githubgilhad/HW-001/HW/KiCad/retro-001/retro-001.png

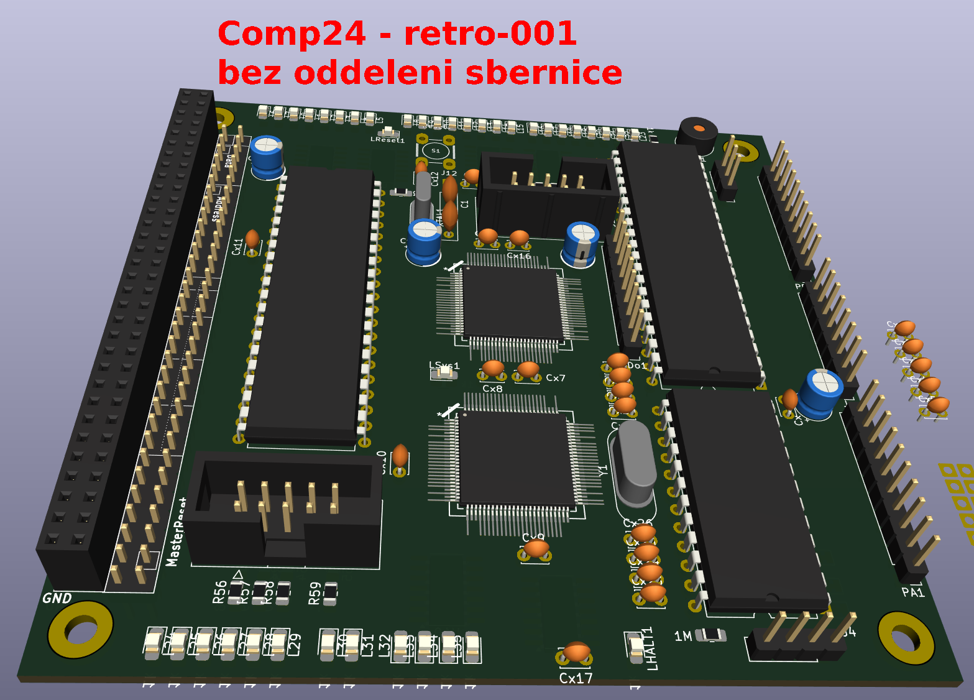
HW/KiCad/retro-001/retro-001.png
