githubgilhad/HW-001/README

HW deska pro CPU+RAM+GLUE+SystemBus - prvni navrh
