githubgilhad/HW-001/HW/KiCad/graphic_card.rst

/home/gilhad/GIT-ghub/Arduino/Video/MegaHomeFORTH/docs/graphic_card.rst
