githubgilhad/HW-001/HW/KiCad/retro-003/retro-003.back.png

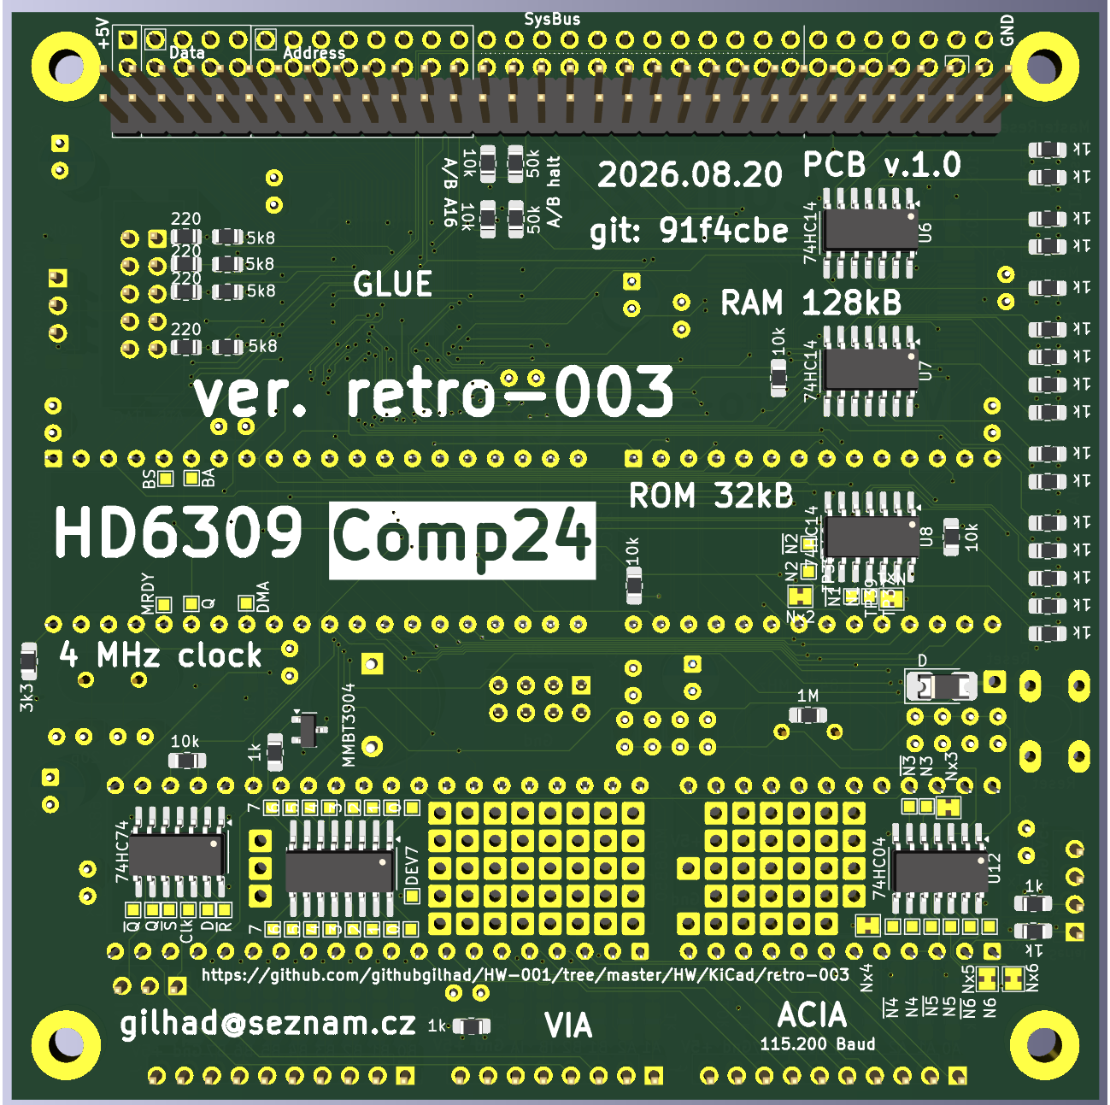
HW/KiCad/retro-003/retro-003.back.png
