githubgilhad/HW-001/HW/KiCad/retro-003/retro-003.front.png

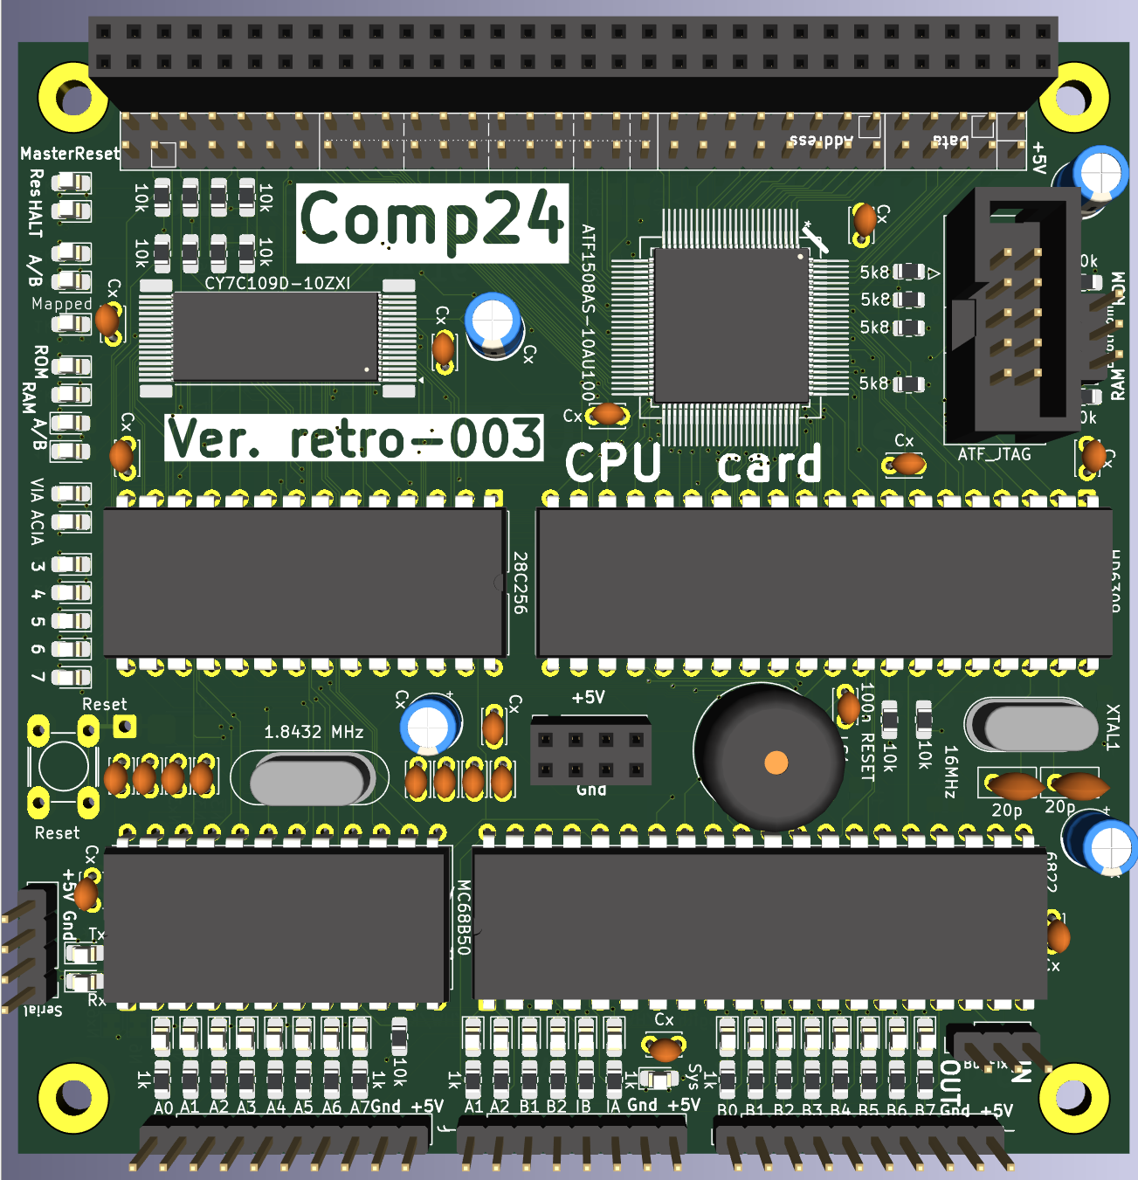
HW/KiCad/retro-003/retro-003.front.png
