githubgilhad/HW-001/PLD/SOviewer/background-retro3-simil-clean.png

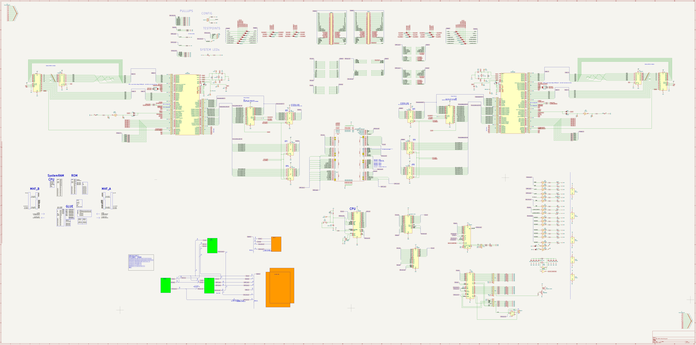
PLD/SOviewer/background-retro3-simil-clean.png
