githubgilhad/HW-001/PLD/SOviewer/background-retro3-simul.png

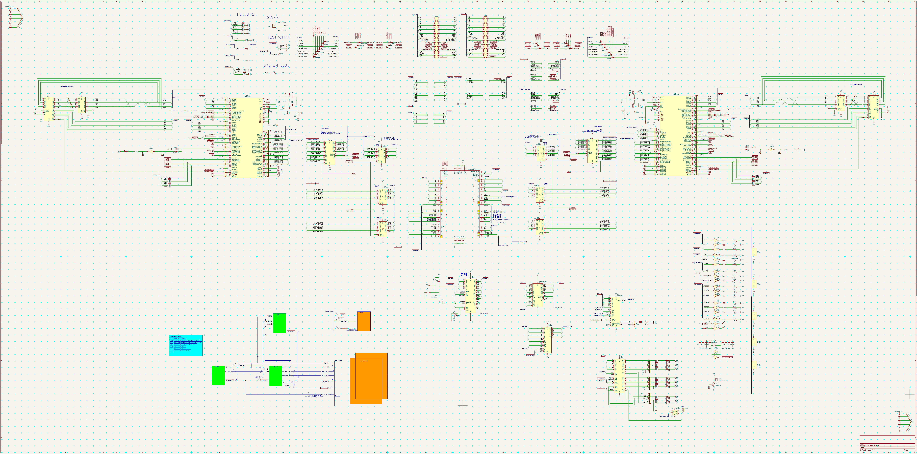
PLD/SOviewer/background-retro3-simul.png
