githubgilhad/HW-001/PLD/SOviewer/background-retro3.small.png

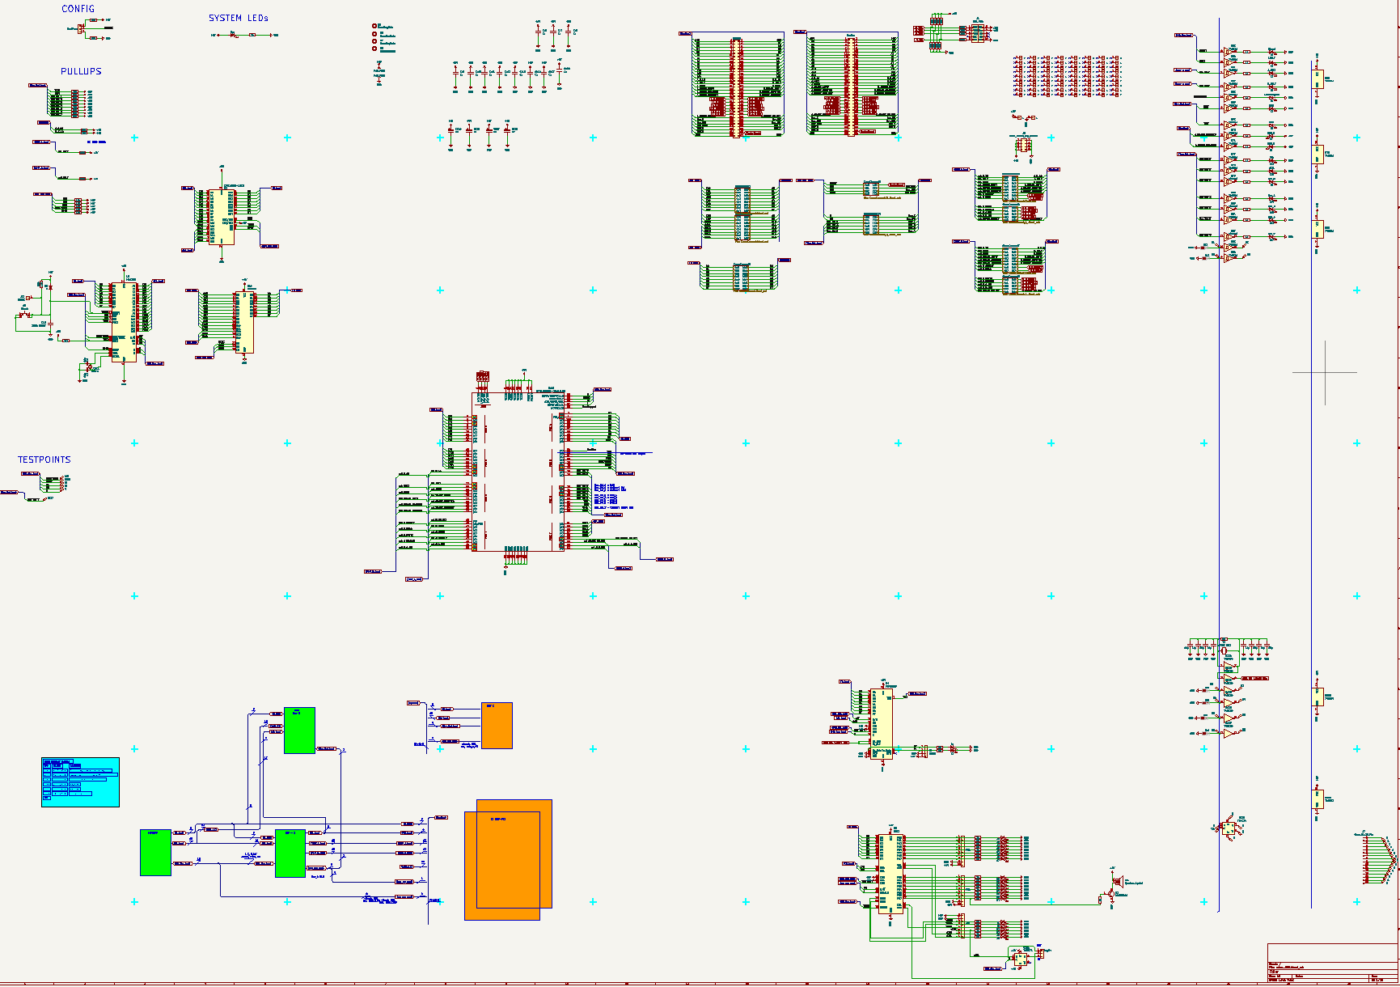
PLD/SOviewer/background-retro3.small.png
