githubgilhad/HW-001/PLD/SOviewer/w-2026-09-04_14:53:48_2492x1393.png

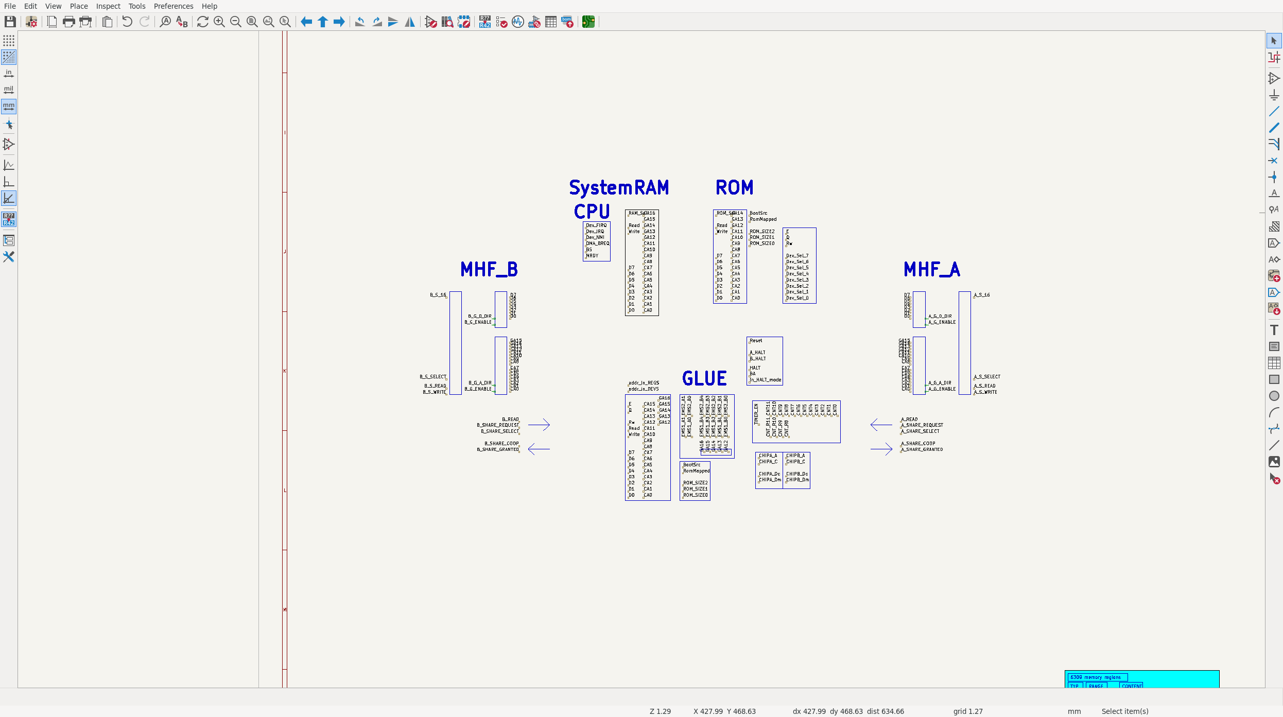
PLD/SOviewer/w-2026-09-04_14:53:48_2492x1393.png
