githubgilhad/HW-001/HW/KiCad/retro-003/STEP Files/EEHZA1E470P.step

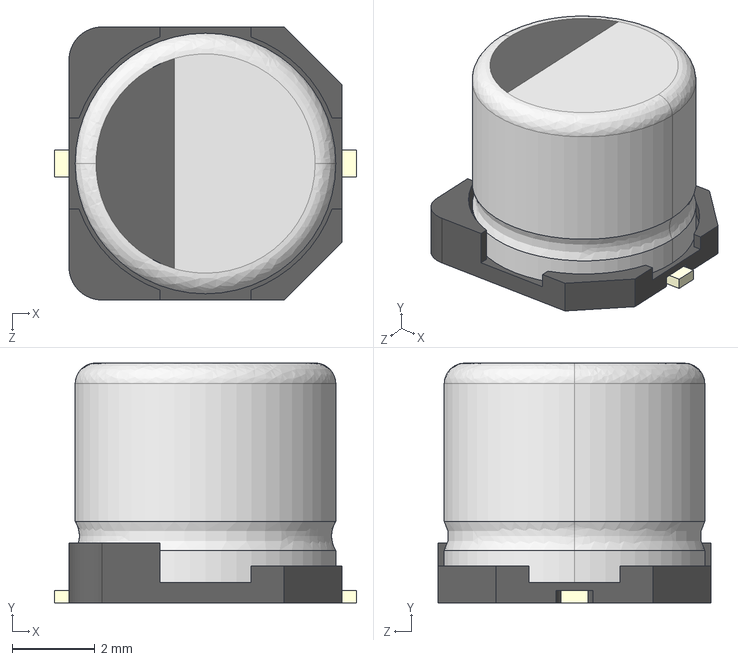
[picture p9: CAD file, 2026-05-15]
HW/KiCad/retro-003/STEP Files/EEHZA1E470P.step
7.30 x 5.80 x 6.60 mm
