githubgilhad/HW-001/HW/KiCad/retro-003/STEP Files/CUI_DEVICES_TS06-667-30-BK-100-G-SMT-TR.step

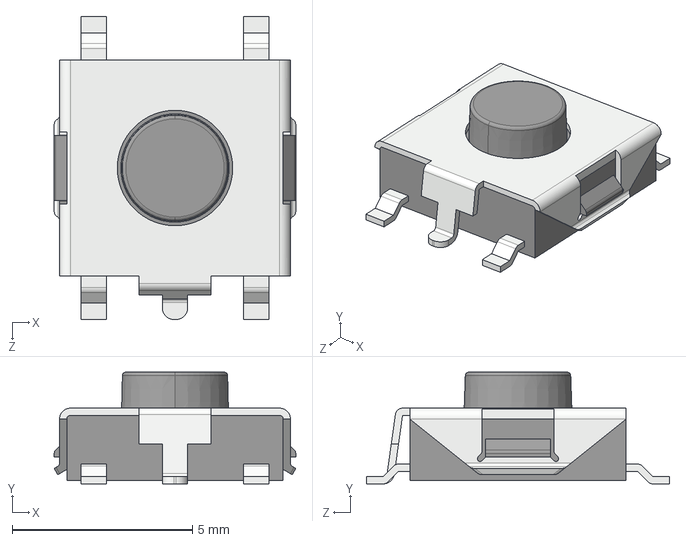
[picture p10: CAD file, 2026-05-15]
HW/KiCad/retro-003/STEP Files/CUI_DEVICES_TS06-667-30-BK-100-G-SMT-TR.step
6.70 x 3.10 x 8.40 mm
