githubgilhad/HW-001/HW/KiCad/retro-003/PCB.pdf

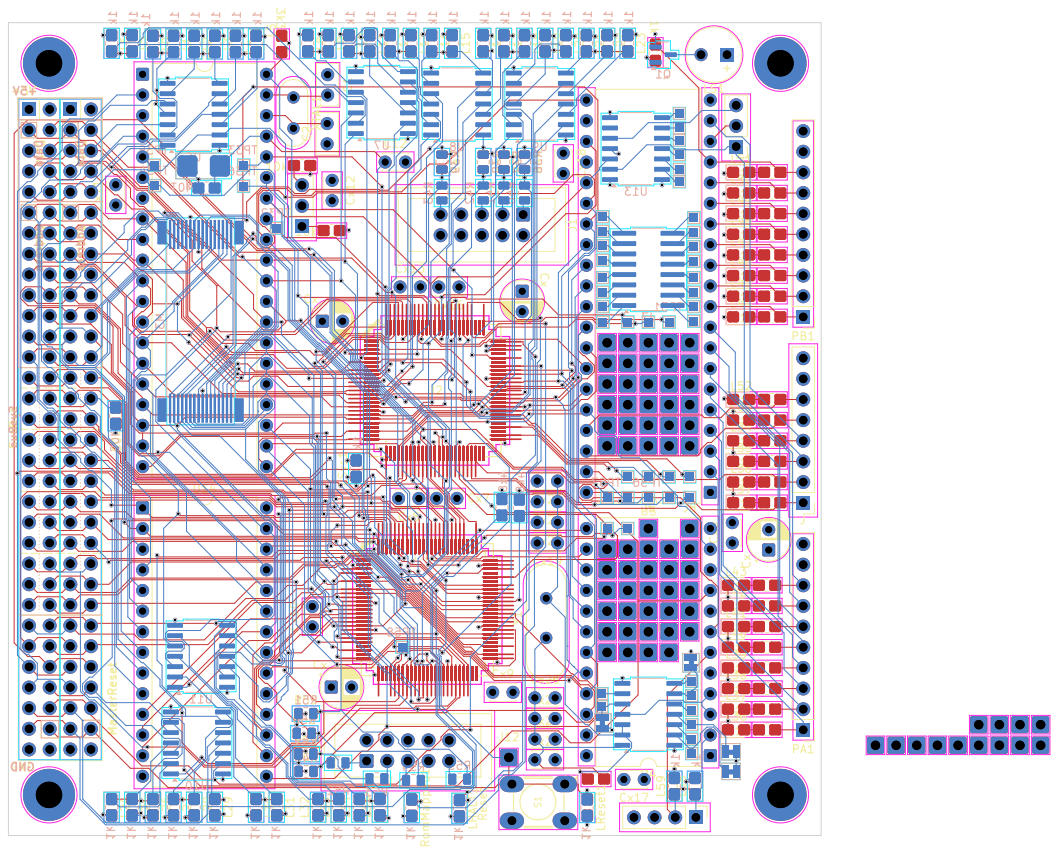
[picture p11: page 1]
