githubgilhad/HW-001/HW/KiCad/retro-003/SCHEMA.pdf

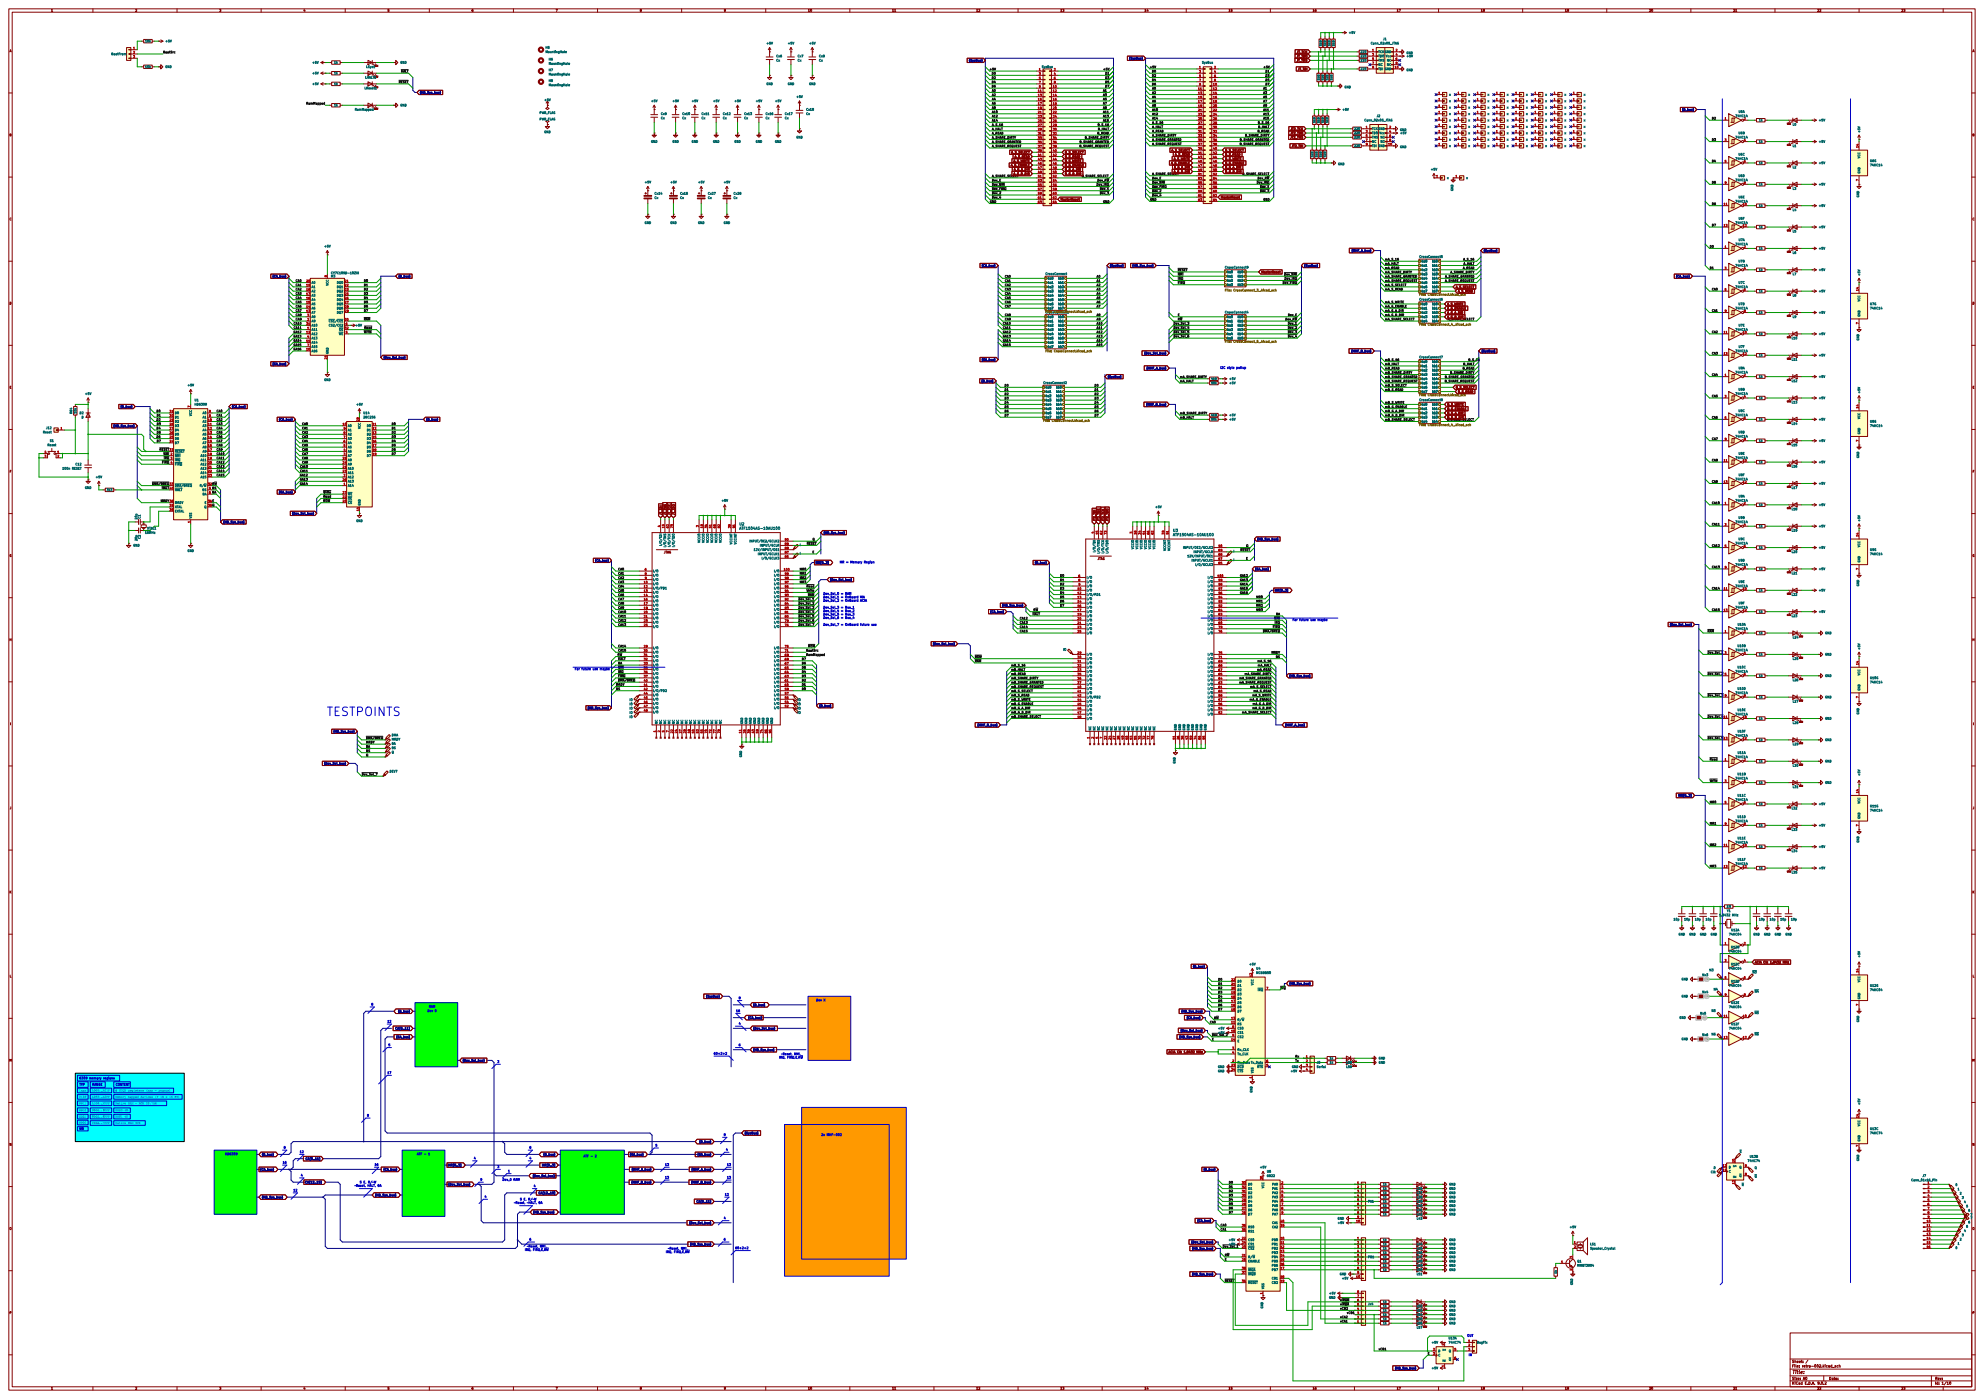
[picture p12: page 1]

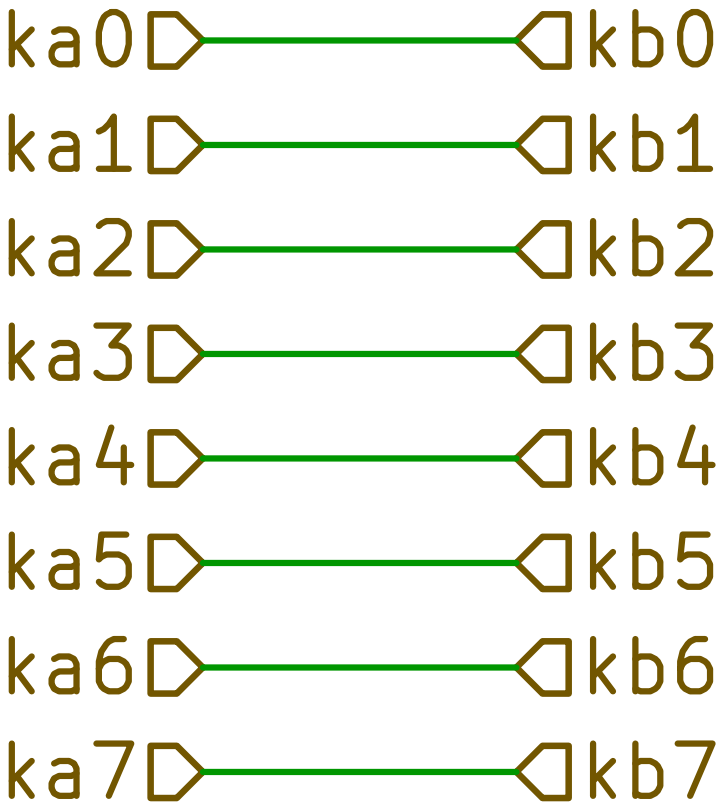
[picture p13: page 2]

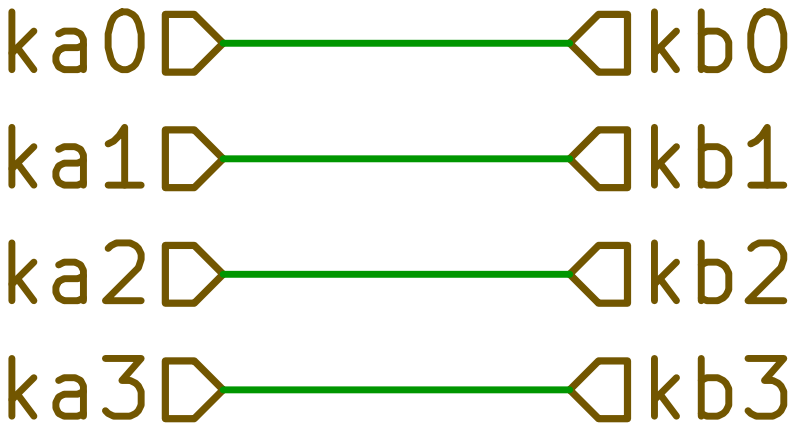
[picture p14: page 5]

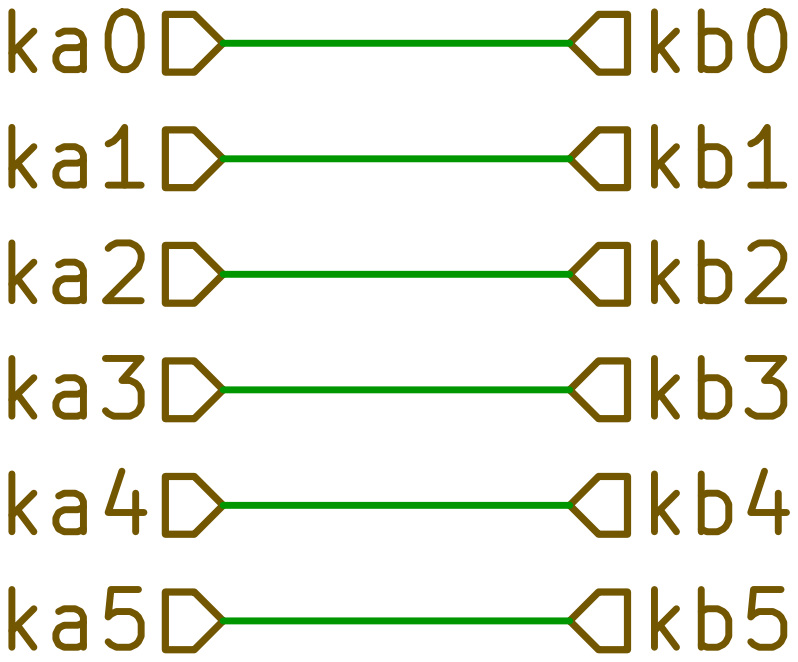
[picture p15: page 6]

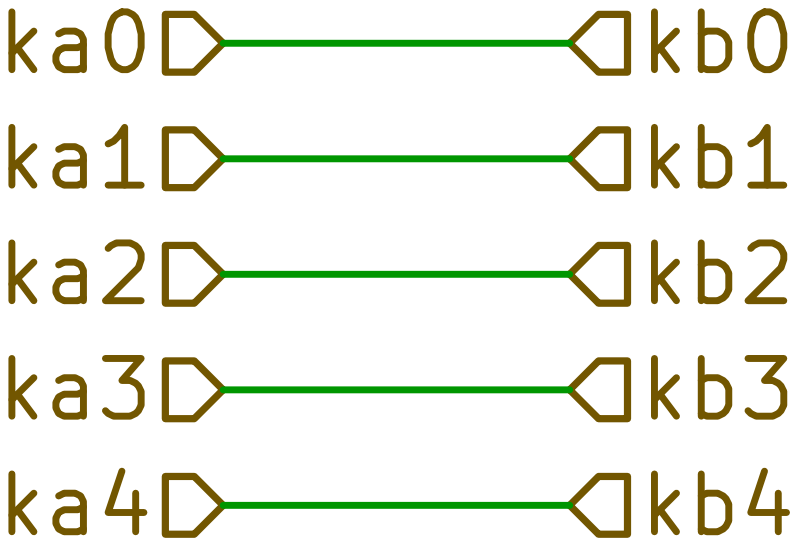
[picture p16: page 8]
