githubgilhad/HW-001/HW/KiCad/retro-001/output.pdf

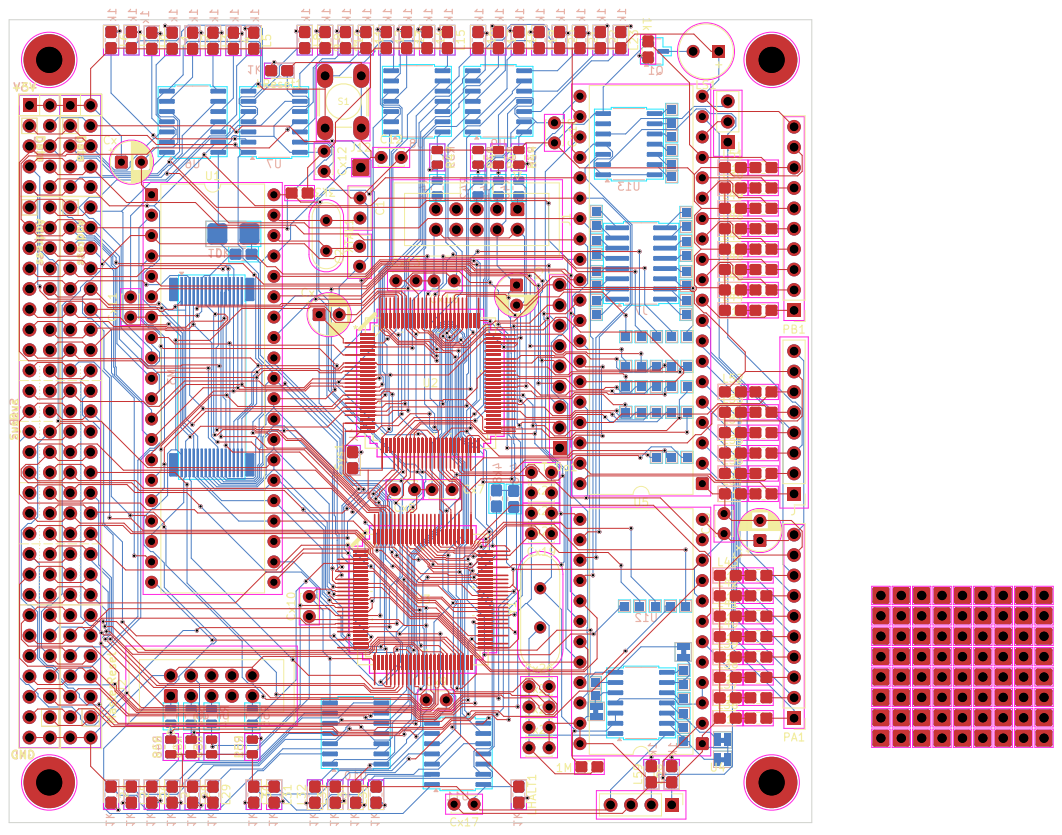
[picture p17: page 1]
