githubgilhad/HW-001/HW/KiCad/retro-001/PCB.pdf

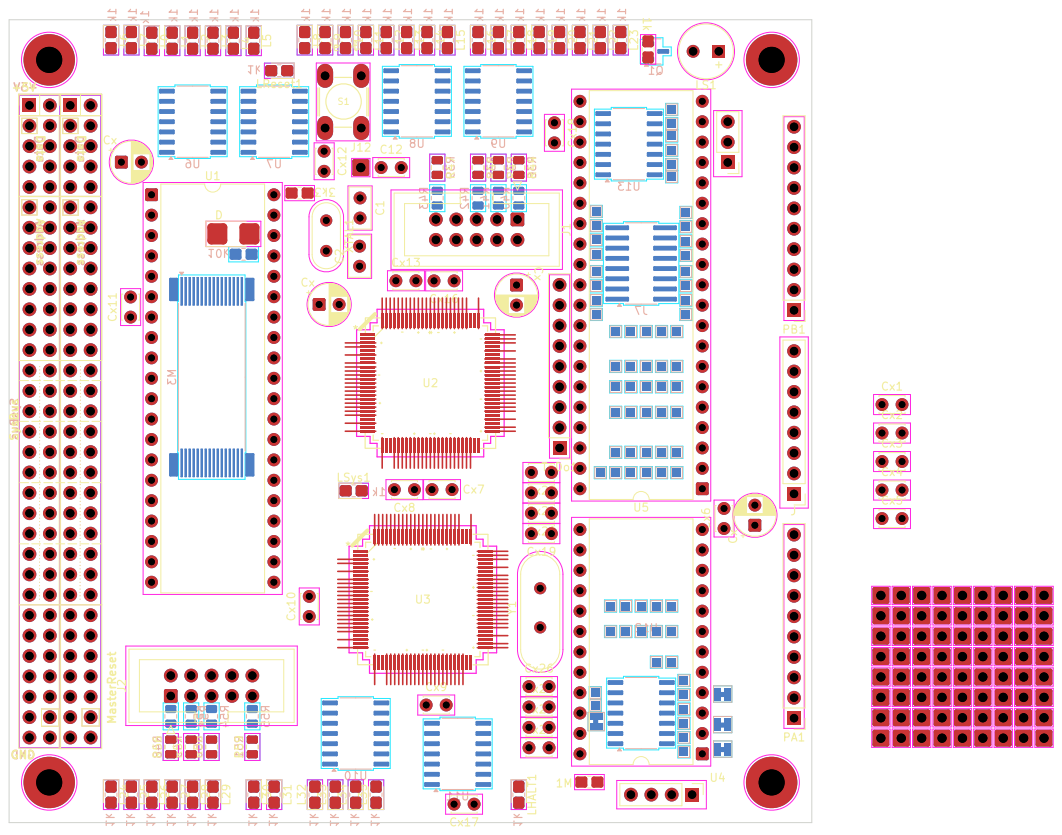
[picture p18: page 1]
