githubgilhad/HW-001/HW/KiCad/retro-001/SCHEMA.pdf

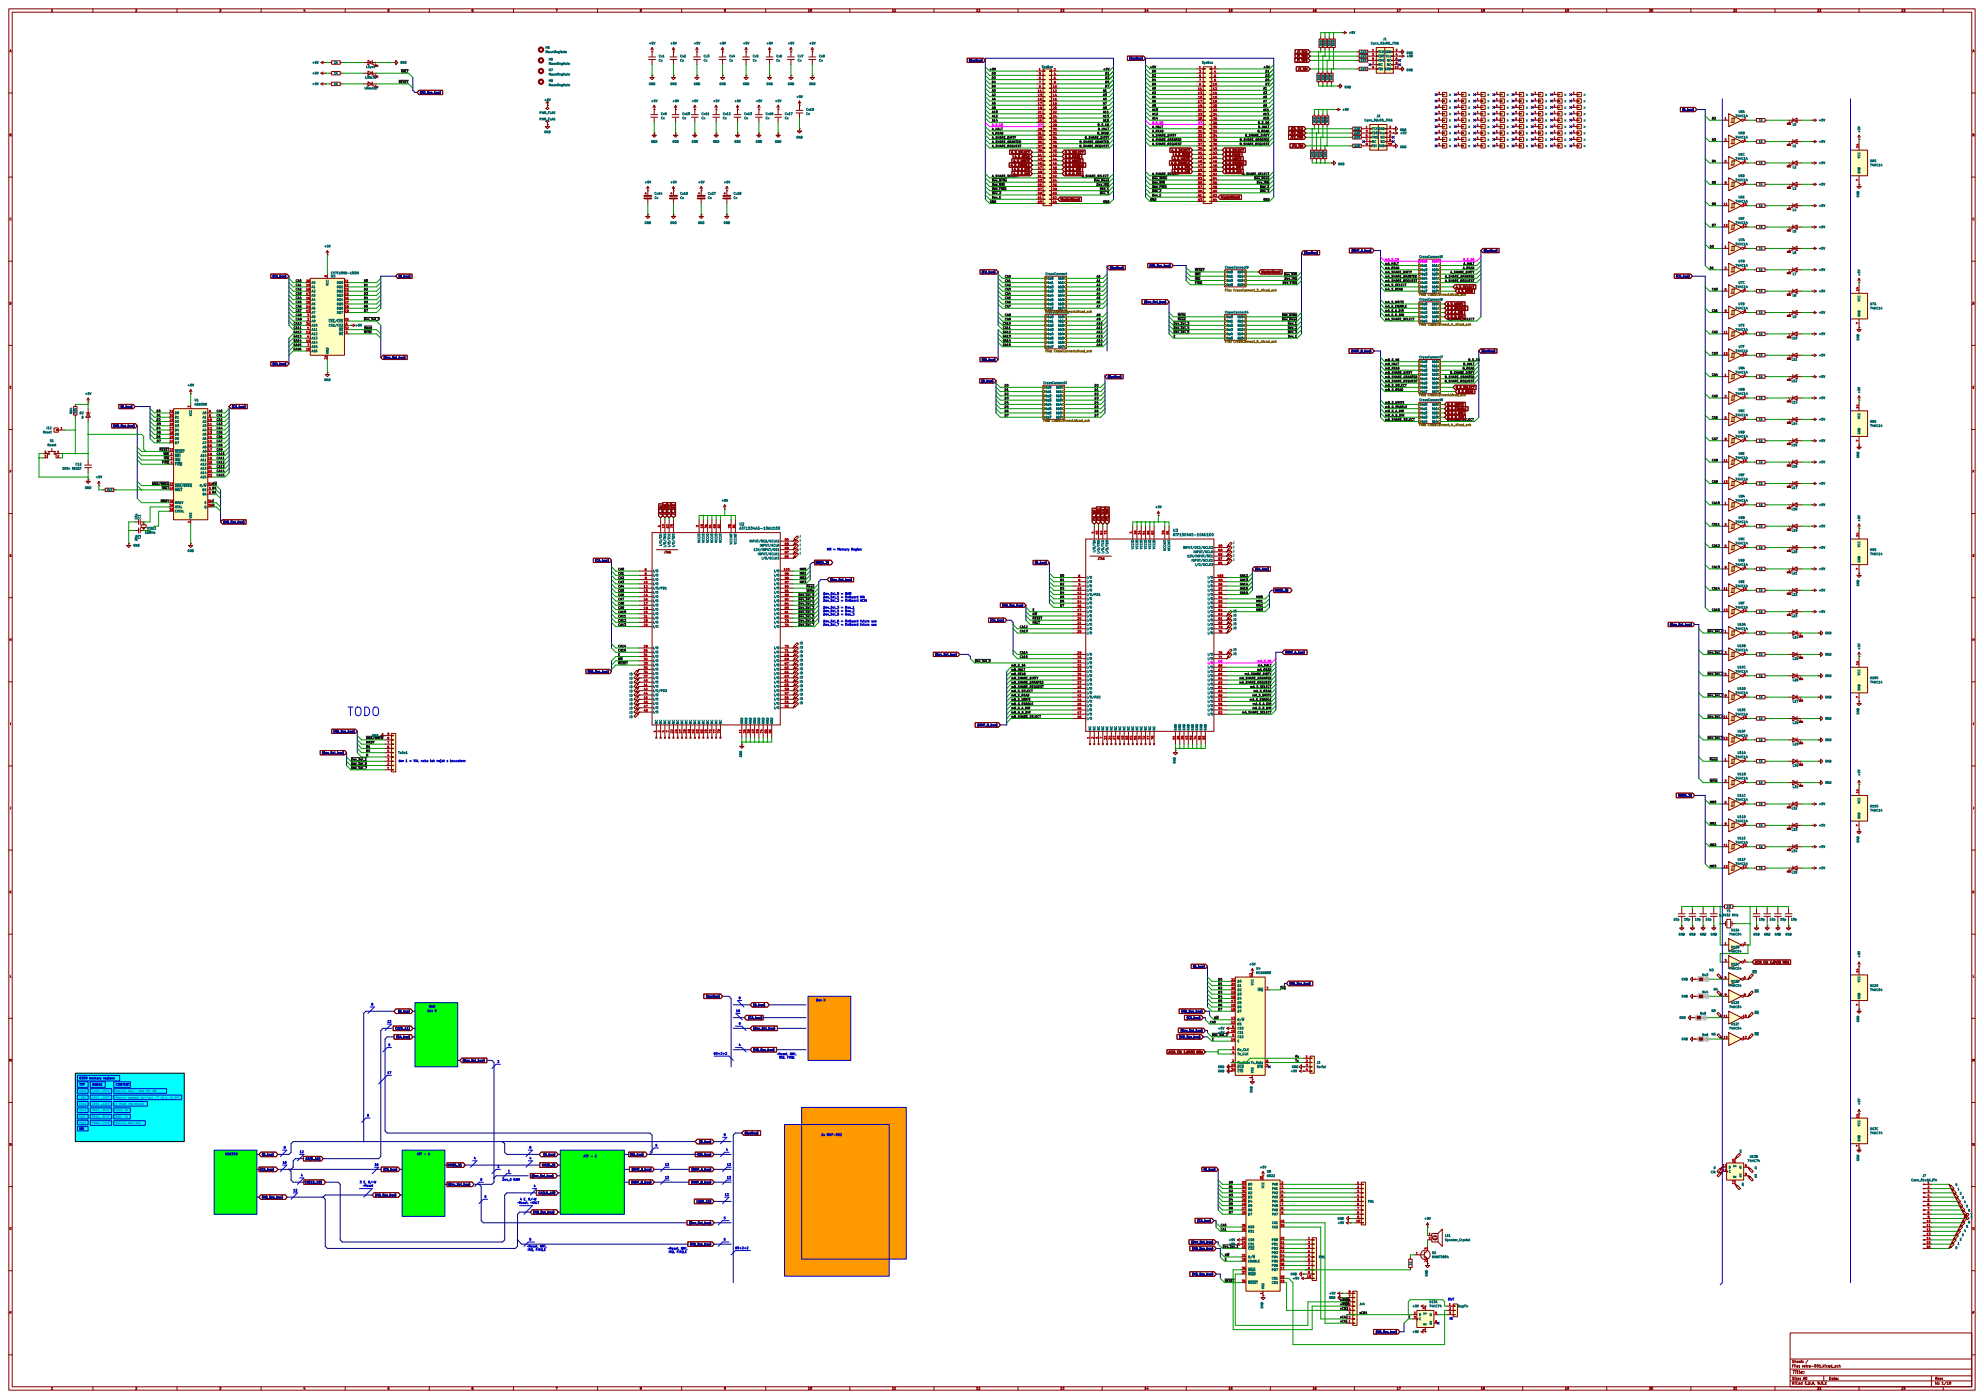
[picture p19: page 1]


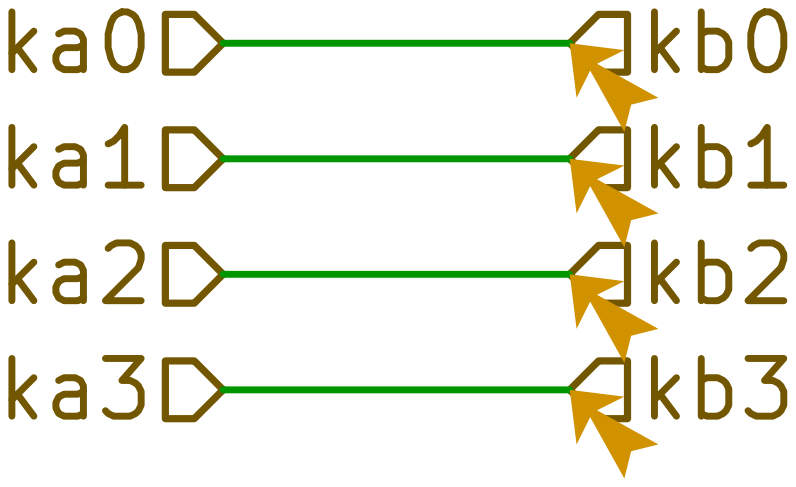
[picture p20: page 5]

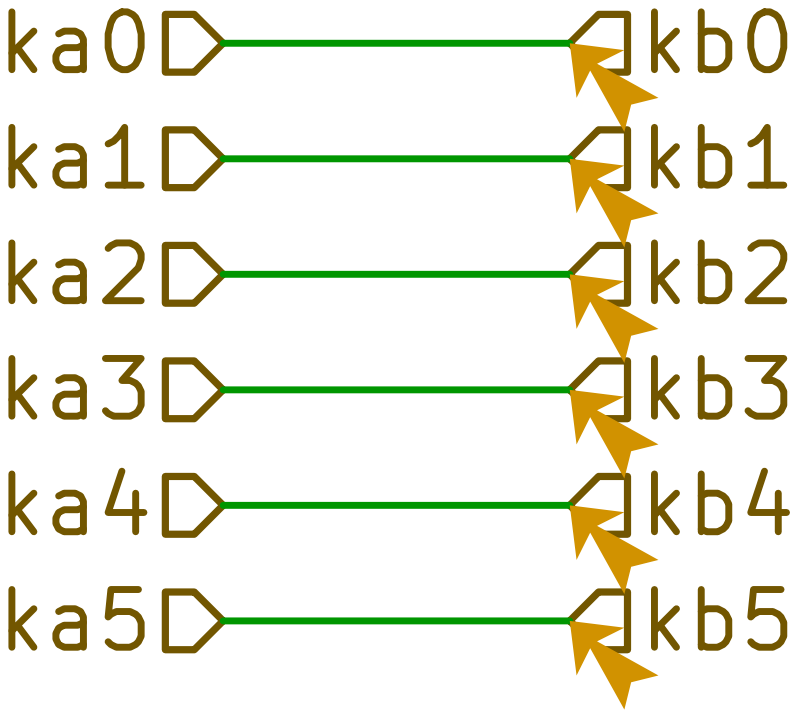
[picture p21: page 6]

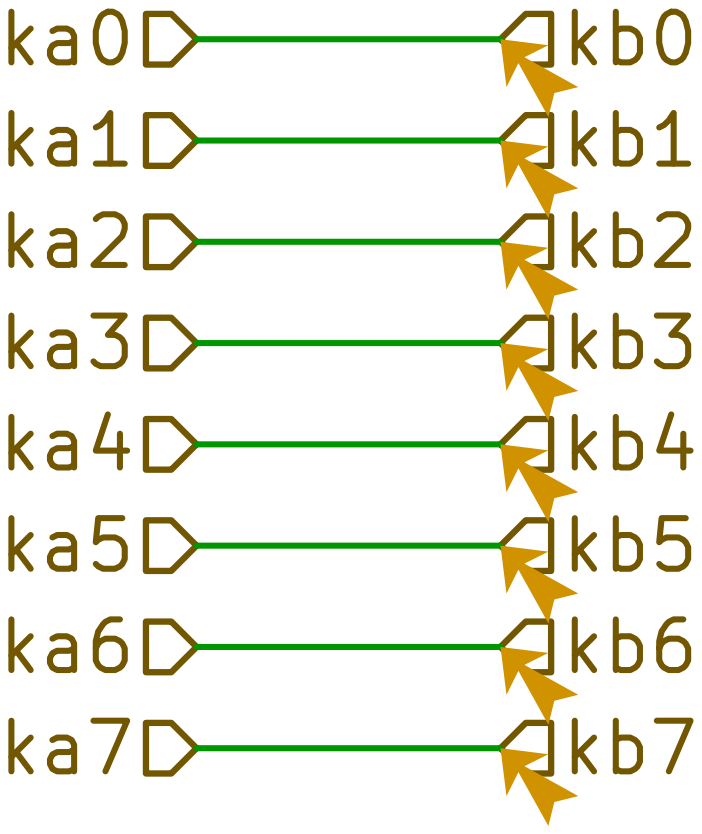
[picture p22: page 7]


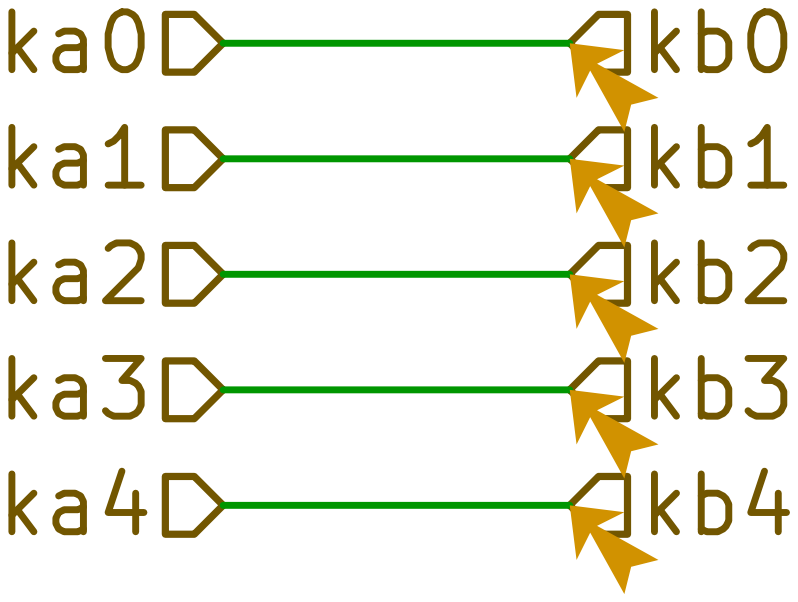
[picture p23: page 10]
