githubgilhad/HW-001/HW/KiCad/retro-003-simul/retro-003-simul.kicad_pcb

## KiCad design neodrive-sch-vehicle/neodrive-sch-vehicle.kicad_sch


Parts:
BT1: Battery 48V 60Ah 15S3P LiFePo4
J1, J2: (no value)
M1, M2: (no value)
RV1: R_Potentiometer
U1, U2: (no value)

Connections:
GND: J1.2, U1., U2.
unnamed: BT1.1 (+), J2.1
unnamed: BT1.2 (-), J2.2
unnamed: J1.1, J2.1
unnamed: J1.2, J2.2
unnamed: M1.1 (Phase_A), U1.
unnamed: M1.2 (Phase_B), U1.
unnamed: M1.3 (Phase_C), U1.
unnamed: M2.1 (Phase_A), U2.
unnamed: M2.2 (Phase_B), U2.
unnamed: M2.3 (Phase_C), U2.
unnamed: RV1.1, U1.
unnamed: RV1.2, U1., U2.
unnamed: RV1.3, U1., U2.
VBUS: J1.1, U1., U2.
