githubgilhad/HW-001/PLD/SOviewer/retro-003-simul.kicad_sch

## KiCad design PLD/SOviewer/retro-003-simul.kicad_sch (2026-09-04)

Schematic: retro-003-simul.kicad_sch

Parts:
C1, C2: 20p; C_Disc_D5.0mm_W2.5mm_P2.50mm
C3, C5: 100n; C_0805_2012Metric_HandSolder
C4, C6, C13, C14: 22p; C_0805_2012Metric_HandSolder
C12: 100n Reset; C_Disc_D3.0mm_W2.0mm_P2.50mm
Cx19, Cx20, Cx21, Cx22, Cx23, Cx24, Cx25, Cx26: 10p; C_Disc_D3.0mm_W2.0mm_P2.50mm
D2: D; D_1210_3225Metric_HandSolder
J1, J15: AREF; PinHole_1x01_2.54xrectangle
J2, J18: XTAL1; PinHole_1x01_2.54xrectangle
J3: Serial; PinHeader_1x04_P2.54mm_Vertical
J4: SysBus; PinSocket_2x32_P2.54mm_Vertical
J5, J16: XTAL2; PinHole_1x01_2.54xrectangle
J6: SysBus; PinHeader_2x32_P2.54mm_Vertical_down
J7, J11: Conn_01x16_Pin; G_SOIC-16_3.9x9.9mm_HandSolder
J8, J19: AVCC; PinHole_1x01_2.54xrectangle
J9, J34: NOTE; PinHole_1x01_2.54xrectangle
J10, J35: NOTEx; PinHole_1x01_2.54xrectangle
J12: Reset; PinHole_1x01_2.54xrectangle
JP1, JP105: GDdir; SolderJumper-3_P1.3mm_Open_RoundedPad1.0x1.5mm
JP2, JP107: GADir; SolderJumper-3_P1.3mm_Open_RoundedPad1.0x1.5mm
JP3, JP106: GEnable; SolderJumper-3_P1.3mm_Open_RoundedPad1.0x1.5mm
JP4: Nx1; SolderJumper-2_P1.3mm_Bridged_Pad1.0x1.5mm
JP5: Nx2; SolderJumper-2_P1.3mm_Bridged_Pad1.0x1.5mm
JP6: B_S_SELECT; SolderJumper-3_P1.3mm_Open_RoundedPad1.0x1.5mm
JP7: B_S_READ; SolderJumper-3_P1.3mm_Open_RoundedPad1.0x1.5mm
JP8: B_S_WRITE; SolderJumper-3_P1.3mm_Open_RoundedPad1.0x1.5mm
JP9: B_S_16; SolderJumper-3_P1.3mm_Open_RoundedPad1.0x1.5mm
JP10, JP94: A_HALT; SolderJumper-3_P1.3mm_Open_RoundedPad1.0x1.5mm
JP11, JP95: A_READ; SolderJumper-3_P1.3mm_Open_RoundedPad1.0x1.5mm
JP12, JP23: HaltLED; SolderJumper-2_P1.3mm_Bridged_Pad1.0x1.5mm
JP13, JP22: XHalt; SolderJumper-2_P1.3mm_Bridged_Pad1.0x1.5mm
JP14, JP19: xAVCC; SolderJumper-2_P1.3mm_Bridged_Pad1.0x1.5mm
JP15, JP98: SHDirty; SolderJumper-3_P1.3mm_Open_RoundedPad1.0x1.5mm
JP16, JP99: SHGranted; SolderJumper-3_P1.3mm_Open_RoundedPad1.0x1.5mm
JP17, JP100: SHRequest; SolderJumper-3_P1.3mm_Open_RoundedPad1.0x1.5mm
JP18, JP38: SHSelect; SolderJumper-3_P1.3mm_Open_RoundedPad1.0x1.5mm
JP20, JP55: PS2_Data; SolderJumper-2_P1.3mm_Open_RoundedPad1.0x1.5mm
JP21, JP56: PS2_CLK; SolderJumper-2_P1.3mm_Open_RoundedPad1.0x1.5mm
JP92: A_S_16; SolderJumper-3_P1.3mm_Open_RoundedPad1.0x1.5mm
JP102: A_S_SELECT; SolderJumper-3_P1.3mm_Open_RoundedPad1.0x1.5mm
JP103: A_S_READ; SolderJumper-3_P1.3mm_Open_RoundedPad1.0x1.5mm
JP104: A_S_WRITE; SolderJumper-3_P1.3mm_Open_RoundedPad1.0x1.5mm
Jx1: BugFix; PinHeader_1x03_P2.54mm_Vertical
Jx2: BootFrom; PinHeader_1x03_P2.54mm_Vertical
Jx4: J; PinHeader_1x08_P2.54mm_Vertical
L0: LReset; LED_0805_2012Metric
L1: LHALT; LED_0805_2012Metric
L2: A_HALT; LED_0805_2012Metric
L3: ROM_Sel; LED_0805_2012Metric
L4: LRomMapped; LED_0805_2012Metric
L5: B_HALT; LED_0805_2012Metric
L6: MHF_B; LED_0805_2012Metric
L7: MHF_A; LED_0805_2012Metric
L8: RAM_Sel; LED_0805_2012Metric
L9: Dev_3; LED_0805_2012Metric
L10: ACIA; LED_0805_2012Metric
L11: VIA; LED_0805_2012Metric
L12: Dev_6; LED_0805_2012Metric
L13: Dev_5; LED_0805_2012Metric
L14: Dev_4; LED_0805_2012Metric
L17: Dev_7; LED_0805_2012Metric
L36: CA0; LED_0805_2012Metric
L37, L57: CA1; LED_0805_2012Metric
L38, L56: CA2; LED_0805_2012Metric
L39: CA3; LED_0805_2012Metric
L40: CA4; LED_0805_2012Metric
L41: CA5; LED_0805_2012Metric
L42: CA6; LED_0805_2012Metric
L43: CA7; LED_0805_2012Metric
L44: B0; LED_0805_2012Metric
L45, L55: B1; LED_0805_2012Metric
L46, L54: B2; LED_0805_2012Metric
L47: B3; LED_0805_2012Metric
L48: B4; LED_0805_2012Metric
L49: B5; LED_0805_2012Metric
L50: B6; LED_0805_2012Metric
L51: B7; LED_0805_2012Metric
L52: IA; LED_0805_2012Metric
L53: IB; LED_0805_2012Metric
L58: Rx; LED_0805_2012Metric
L59: Tx; LED_0805_2012Metric
LED1, LED8: HALT; LED_0805_2012Metric
LS1: Speaker_Crystal; Buzzer_12x9.5RM7.6
LSys1: Sys; LED_0805_2012Metric
M1, M2, M3, M4, M5: CY7C109D-10ZXI; G_TSOP-I-32_18.4x8mm_HandSolder
PA1: J; PinHeader_1x10_P2.54mm_Vertical
PA2, PA3: PA; PinHeader_1x09_P2.54mm_Vertical
PB1: J; PinHeader_1x10_P2.54mm_Vertical
PB2, PB3: PB; PinHeader_1x09_P2.54mm_Vertical
PC1, PC2: PC; PinHeader_1x09_P2.54mm_Vertical
PD1, PD2: PD; PinHeader_1x09_P2.54mm_Vertical
PE1, PE2: PE; PinHeader_1x09_P2.54mm_Vertical
PF1, PF2: PF; PinHeader_1x09_P2.54mm_Vertical
PG1, PG2: PG; PinHeader_1x07_P2.54mm_Vertical
PH1, PH2: PH; PinHeader_1x09_P2.54mm_Vertical
PJ1, PJ2: PJ; PinHeader_1x09_P2.54mm_Vertical
PK1, PK2: PK; PinHeader_1x09_P2.54mm_Vertical
PL1, PL2: PL; PinHeader_1x09_P2.54mm_Vertical
Q1: MMBT3904; SOT-23
R0, R1, R2, R3, R4, R5, R6, R7, R8, R9, R10, R11, R12, R13, R14, R16, R17, R18, R28, R30, R39, R43, R61, R62, R69, R70, R71, R72, R73, R74, R75, R76, R77, R78, R79, R80, R81, R82, R83, R84, R85, R86, R87, R88, R89, R90, R91, R92: 1k; R_0805_2012Metric_Pad1.20x1.40mm_HandSolder
R15, R24: 0?; R_0805_2012Metric_Pad1.20x1.40mm_HandSolder
R19, R20, R21, R22, R23, R26, R27, R31, R32, R33, R34, R35, R36, R37, R38, R44, R45, R48, R49, R50, R51, R52, R53, R54, R55, R56, R57, R58, R59, R64, R95, R96, R98, R99, R100, R102: 10k; R_0805_2012Metric_Pad1.20x1.40mm_HandSolder
R25, R29, R60: 1M; R_0805_2012Metric_Pad1.20x1.40mm_HandSolder
R63: 3k3; R_0805_2012Metric_Pad1.20x1.40mm_HandSolder
R93, R94: 50k; R_0805_2012Metric_Pad1.20x1.40mm_HandSolder
S1: Reset; G_Arduino_switch; PARTREV 1.0
TP1, TP16, TP24, TP42, TP57, TP58: 7; TestPoint_Pad_1.0x1.0mm
TP2, TP9, TP17, TP25, TP43, TP44: 0; TestPoint_Pad_1.0x1.0mm
TP3, TP10, TP18, TP26, TP45, TP46: 1; TestPoint_Pad_1.0x1.0mm
TP4, TP11, TP19, TP27, TP47, TP48: 2; TestPoint_Pad_1.0x1.0mm
TP5, TP12, TP20, TP28, TP49, TP50: 3; TestPoint_Pad_1.0x1.0mm
TP6, TP13, TP21, TP29, TP51, TP52: 4; TestPoint_Pad_1.0x1.0mm
TP7, TP14, TP22, TP30, TP53, TP54: 5; TestPoint_Pad_1.0x1.0mm
TP8, TP15, TP23, TP41, TP55, TP56: 6; TestPoint_Pad_1.0x1.0mm
TP31: DEV7; TestPoint_Pad_1.0x1.0mm
TP32: DMA; TestPoint_Pad_1.0x1.0mm
TP33: MRDY; TestPoint_Pad_1.0x1.0mm
TP34: BA; TestPoint_Pad_1.0x1.0mm
TP35: BS; TestPoint_Pad_1.0x1.0mm
TP36: Q; TestPoint_Pad_1.0x1.0mm
TP37: N1; TestPoint_Pad_1.0x1.0mm
TP38: N2; TestPoint_Pad_1.0x1.0mm
TP39: ~{N1}; TestPoint_Pad_1.0x1.0mm
TP40: ~{N2}; TestPoint_Pad_1.0x1.0mm
U1: HD6309; DIP-40_W15.24mm
U2, U10, U11, U16, U17, U18: 74HC245; G_SOIC-20W_7.5x12.8mm_P1.27mm_HandSolder
U3, U19: ATMEGA2560; G_TQFP-100_14x14mm_HandSolder
U4: MC68B50; DIP-24_W15.24mm
U5: 6822; DIP-40_W15.24mm
U6, U7, U8, U20: 74HC14; SOIC-14_3.9x8.7mm_P1.27mm
U9, U21: 74AHC573; TSSOP-20_4.4x6.5mm_P0.65mm_HandSolder
U12: 74HC04; SOIC-14_3.9x8.7mm_P1.27mm
U13: 74HC74; SOIC-14_3.9x8.7mm_P1.27mm
U14: 28C256; DIP-28_W15.24mm
U15: ATF1508AS-10AU100; ATF1508-AS_TQFP100_long
XTAL1: 16MHz; Crystal_HC49-4H_Vertical
Y1: 1.8432 MHz; Crystal_THT_15_5mm
Y2, Y3: 16 MHz; Crystal_SMD_HC49-SD

Connections:
16MHz: PE1.8, PE2.8, U3.9 ((CLKO/ICP3/INT7)PE7), U19.9 ((CLKO/ICP3/INT7)PE7)
+5V: D2.1 (K), J3.4, J4.1, J4.2, J6.1, J6.2, JP14.1 (A), JP19.1 (A), Jx4.8, L6.2 (A), L7.2 (A), LS1.1, LSys1.2 (A), M1.6 (CS2/CE2), M1.8 (VCC), M2.6 (CS2/CE2), M2.8 (VCC), M3.6 (CS2/CE2), M3.8 (VCC), M4.6 (CS2/CE2), M4.8 (VCC), M5.6 (CS2/CE2), M5.8 (VCC), PA1.10, PB1.10, R15.1, R24.1, R48.2, R49.2, R50.2, R51.2, R52.2, R53.2, R54.2, R55.2, R56.2, R57.2, R58.2, R59.2, R63.1, R64.1, R93.1, R94.1, R95.2, R98.2, R99.2, R100.2, R102.2, U1.7 (VCC), U2.20 (VCC), U3.10 (VCC), U3.31 (VCC1), U3.61 (VCC2), U3.80 (VCC3), U4.8 (CS0), U4.10 (CS1), U4.12 (VCC), U5.20 (VCC), U5.22 (CS0), U5.24 (CS1), U6.14 (VCC), U7.14 (VCC), U8.14 (VCC), U9.20 (VCC), U11.20 (VCC), U12.14 (VCC), U13.1 (~R), U13.4 (~S), U13.14 (VCC), U14.28 (VCC), U15.3 (VCCIO), U15.18 (VCCIO), U15.34 (VCCIO), U15.39 (VCCINT), U15.51 (VCCIO), U15.66 (VCCIO), U15.82 (VCCIO), U15.91 (VCCINT), U16.20 (VCC), U17.20 (VCC), U19.10 (VCC), U19.31 (VCC1), U19.61 (VCC2), U19.80 (VCC3), U21.20 (VCC)
ACIA Clk 1.8432 MHz: U4.3 (Rx_CLK), U4.4 (Tx_CLK), U12.4
ALE: PG1.3, PG2.3, U3.70 ((ALE)PG2), U9.11 (Load), U19.70 ((ALE)PG2), U21.11 (Load)
AREF: C3.1, C5.1, J1.1, J15.1, U3.98 (AREF), U19.98 (AREF)
A_G_A_DIR: J4.47, J6.47, JP2.1 (A), JP107.1 (A), JP107.2 (C), U2.1, U11.1 (A->B), U15.49 (I/O)
A_G_D_DIR: J4.49, J6.49, JP1.1 (A), JP105.1 (A), JP105.2 (C), U10.1 (A->B), U15.52 (I/O)
A_G_ENABLE: J4.45, J6.45, JP3.1 (A), JP106.1 (A), JP106.2 (C), U2.19 (CE), U10.19 (CE), U11.19 (CE), U15.47 (I/O)
A_HALT: J4.29, J6.29, JP10.1 (A), JP13.2 (B), JP94.1 (A), JP94.2 (C), R93.2, U6.1, U15.27 (I/O)
A_READ: J4.31, J6.31, JP11.1 (A), JP95.1 (A), JP95.2 (C), PD1.8, U3.50 ((T0)PD7), U15.29 (I/O)
A_SHARE_COOP: J4.33, J6.33, JP15.1 (A), JP98.1 (A), JP98.2 (C), PD1.7, U3.49 ((T1)PD6), U15.31 (I/O)
A_SHARE_GRANTED: J4.35, J6.35, JP16.1 (A), JP99.1 (A), JP99.2 (C), R18.2, U7.3, U15.33 (I/O)
A_SHARE_REQUEST: J4.37, J6.37, JP17.1 (A), JP17.2 (C), JP100.1 (A), JP100.2 (C), M1.10 (A16), M4.10 (A16), PG1.4, PG1.5, PG2.4, PG2.5, U3.28 ((TOSC2)PG3), U3.29 ((TOSC1)PG4), U15.36 (I/O), U19.28 ((TOSC2)PG3), U19.29 ((TOSC1)PG4)
A_SHARE_SELECT: J4.51, J6.51, JP18.1 (A), JP38.1 (A), JP38.2 (C), PG1.6, U3.1 ((OC0B)PG5), U15.54 (I/O)
A_S_16: J4.27, J6.27, JP9.1 (A), JP92.1 (A), JP92.2 (C), M5.10 (A16), PE1.4, R100.1, U3.5 ((OC3A/AIN1)PE3), U15.24 (I/O)
A_S_READ: J4.41, J6.41, JP7.1 (A), JP103.1 (A), JP103.2 (C), M5.32 (~OE), U15.42 (I/O)
A_S_SELECT: J4.39, J6.39, JP6.1 (A), JP102.1 (A), JP102.2 (C), M5.30 (~CS1/~CE1), U15.40 (I/O)
A_S_WRITE: J4.43, J6.43, JP8.1 (A), JP104.1 (A), JP104.2 (C), M5.5 (~WE), U15.45 (I/O)
BA: TP34.1, U1.6 (BA), U15.88 (12V/INPUT/OE1)
BS: TP35.1, U1.5 (BS), U15.77 (I/O)
B_G_A_DIR: J4.48, J6.48, JP2.2 (C), JP2.3 (B), JP107.3 (B), U15.50 (I/O), U16.1 (A->B), U17.1 (A->B)
B_G_D_DIR: J4.50, J6.50, JP1.2 (C), JP1.3 (B), JP105.3 (B), U15.53 (I/O), U18.1 (A->B)
B_G_ENABLE: J4.46, J6.46, JP3.2 (C), JP3.3 (B), JP106.3 (B), U15.48 (I/O), U16.19 (CE), U17.19 (CE), U18.19 (CE)
B_HALT: J4.30, J6.30, JP10.2 (C), JP10.3 (B), JP22.2 (B), JP94.3 (B), R94.2, U6.13, U15.28 (I/O)
B_READ: J4.32, J6.32, JP11.2 (C), JP11.3 (B), JP95.3 (B), PD2.8, U15.30 (I/O), U19.50 ((T0)PD7)
B_SHARE_COOP: J4.34, J6.34, JP15.2 (C), JP15.3 (B), JP98.3 (B), PD2.7, U15.32 (I/O), U19.49 ((T1)PD6)
B_SHARE_GRANTED: J4.36, J6.36, JP16.2 (C), JP16.3 (B), JP99.3 (B), R30.2, U7.1, U15.35 (I/O)
B_SHARE_REQUEST: J4.38, J6.38, JP17.3 (B), JP100.3 (B), U15.37 (I/O)
B_SHARE_SELECT: J4.52, J6.52, JP18.2 (C), JP18.3 (B), JP38.3 (B), PG2.6, U15.55 (I/O), U19.1 ((OC0B)PG5)
B_S_16: J4.28, J6.28, JP9.2 (C), JP9.3 (B), JP92.3 (B), M2.10 (A16), PE2.4, R102.1, U15.25 (I/O), U19.5 ((OC3A/AIN1)PE3)
B_S_READ: J4.42, J6.42, JP7.2 (C), JP7.3 (B), JP103.3 (B), M2.32 (~OE), U15.44 (I/O)
B_S_SELECT: J4.40, J6.40, JP6.2 (C), JP6.3 (B), JP102.3 (B), M2.30 (~CS1/~CE1), U15.41 (I/O/PD2)
B_S_WRITE: J4.44, J6.44, JP8.2 (C), JP8.3 (B), JP104.3 (B), M2.5 (~WE), U15.46 (I/O)
Bb: PH1.2, PH2.2, U3.13 (PH1(TXD2)), U19.13 (PH1(TXD2))
Bf: PH1.6, PH2.6, U3.17 (PH5(OC4C)), U19.17 (PH5(OC4C))
BootSrc: Jx2.2, U15.84 (I/O)
CA0: J4.11, J6.11, M3.20 (A0), U1.8 (A0), U4.11 (RS), U5.36 (RS0), U11.18 (B0), U14.10 (A0), U15.5 (I/O), U16.18 (B0)
CA1: J4.12, J6.12, M3.19 (A1), U1.9 (A1), U5.35 (RS1), U11.17 (B1), U14.9 (A1), U15.6 (I/O), U16.17 (B1)
CA2: J4.13, J6.13, M3.18 (A2), U1.10 (A2), U11.16 (B2), U14.8 (A2), U15.7 (I/O), U16.16 (B2)
CA3: J4.14, J6.14, M3.17 (A3), U1.11 (A3), U11.15 (B3), U14.7 (A3), U15.8 (I/O), U16.15 (B3)
CA4: J4.15, J6.15, M3.16 (A4), U1.12 (A4), U11.14 (B4), U14.6 (A4), U15.9 (I/O), U16.14 (B4)
CA5: J4.16, J6.16, M3.15 (A5), U1.13 (A5), U11.13 (B5), U14.5 (A5), U15.10 (I/O), U16.13 (B5)
CA6: J4.17, J6.17, M3.14 (A6), U1.14 (A6), U11.12 (B6), U14.4 (A6), U15.12 (I/O), U16.12 (B6)
CA7: J4.18, J6.18, M3.13 (A7), U1.15 (A7), U11.11 (B7), U14.3 (A7), U15.13 (I/O), U16.11 (B7)
CA8: J4.19, J6.19, M3.3 (A8), U1.16 (A8), U2.18 (B0), U14.25 (A8), U15.14 (I/O), U17.18 (B0)
CA9: J4.20, J6.20, M3.2 (A9), U1.17 (A9), U2.17 (B1), U14.24 (A9), U15.16 (I/O), U17.17 (B1)
CA10: J4.21, J6.21, M3.31 (A10), U1.18 (A10), U2.16 (B2), U14.21 (A10), U15.17 (I/O), U17.16 (B2)
CA11: J4.22, J6.22, M3.1 (A11), U1.19 (A11), U2.15 (B3), U14.23 (A11), U15.19 (I/O), U17.15 (B3)
CA12: U1.20 (A12), U15.20 (I/O)
CA13: U1.21 (A13), U15.21 (I/O)
CA14: U1.22 (A14), U15.22 (I/O)
CA15: U1.23 (A15), U15.23 (I/O)
CTS0: PB2.5, PB3.5, U3.23 ((OC2A/PCINT4)PB4), U19.23 ((OC2A/PCINT4)PB4)
D0: J4.3, J6.3, M3.21 (DQ0), U1.31 (D0), U4.22 (D0), U5.33 (D0), U10.18 (B0), U14.11 (D0), U15.94 (I/O), U18.18 (B0)
D1: J4.4, J6.4, M3.22 (DQ1), U1.30 (D1), U4.21 (D1), U5.32 (D1), U10.17 (B1), U14.12 (D1), U15.96 (I/O), U18.17 (B1)
D2: J4.5, J6.5, M3.23 (DQ2), U1.29 (D2), U4.20 (D2), U5.31 (D2), U10.16 (B2), U14.13 (D2), U15.97 (I/O), U18.16 (B2)
D3: J4.6, J6.6, M3.25 (DQ3), U1.28 (D3), U4.19 (D3), U5.30 (D3), U10.15 (B3), U14.15 (D3), U15.98 (I/O), U18.15 (B3)
D4: J4.7, J6.7, M3.26 (DQ4), U1.27 (D4), U4.18 (D4), U5.29 (D4), U10.14 (B4), U14.16 (D4), U15.99 (I/O), U18.14 (B4)
D5: J4.8, J6.8, M3.27 (DQ5), U1.26 (D5), U4.17 (D5), U5.28 (D5), U10.13 (B5), U14.17 (D5), U15.100 (I/O), U18.13 (B5)
D6: J4.9, J6.9, M3.28 (DQ6), U1.25 (D6), U4.16 (D6), U5.27 (D6), U10.12 (B6), U14.18 (D6), U15.1 (PD1/I/O), U18.12 (B6)
D7: J4.10, J6.10, M3.29 (DQ7), U1.24 (D7), U4.15 (D7), U5.26 (D7), U10.11 (B7), U14.19 (D7), U15.2 (I/O), U18.11 (B7)
Debug_LEDs: R16.2, R28.2
Dev_E: J4.53, J6.53
E: U1.34 (E), U4.14 (E), U5.25 (ENABLE), U13.3 (C), U15.87 (INPUT/GCLK1)
GA12: J4.23, J6.23, M3.12 (A12), U2.14 (VCC), U14.2 (A12), U15.61 (I/O), U17.14 (B4)
GA13: J4.24, J6.24, M3.4 (A13), U2.13, U14.26 (A13), U15.60 (I/O), U17.13 (B5)
GA14: J4.25, J6.25, M3.11 (A14), U2.12, U14.1 (A14), U15.58 (I/O), U17.12 (B6)
GA15: J4.26, J6.26, M3.7 (A15), U2.11, U15.57 (I/O), U17.11 (B7)
GA16: M3.10 (A16), U15.56 (I/O)
GND: C1.1, C2.1, C3.2, C4.1, C5.2, C6.1, C12.2, C13.1, C14.1, Cx19.2, Cx20.2, Cx21.2, Cx22.2, Cx23.2, Cx24.2, Cx25.2, Cx26.2, J3.3, J4.63, J4.64, J6.63, J6.64, JP4.1 (A), JP5.1 (A), Jx4.7, L0.1 (K), L1.1 (K), L2.1 (K), L3.1 (K), L4.1 (K), L5.1 (K), L8.1 (K), L9.1 (K), L10.1 (K), L11.1 (K), L12.1 (K), L13.1 (K), L14.1 (K), L17.1 (K), L36.1 (K), L37.1 (K), L38.1 (K), L39.1 (K), L40.1 (K), L41.1 (K), L42.1 (K), L43.1 (K), L44.1 (K), L45.1 (K), L46.1 (K), L47.1 (K), L48.1 (K), L49.1 (K), L50.1 (K), L51.1 (K), L52.1 (K), L53.1 (K), L54.1 (K), L55.1 (K), L56.1 (K), L57.1 (K), L58.1 (K), L59.1 (K), LED1.1 (K), LED8.1 (K), M1.24 (GND), M1.30 (~CS1/~CE1), M2.24 (GND), M3.24 (GND), M4.24 (GND), M4.30 (~CS1/~CE1), M5.24 (GND), PA1.9, PA2.9, PA3.9, PB1.9, PB2.9, PB3.9, PC1.9, PC2.9, PD1.9, PD2.9, PE1.9, PE2.9, PF1.9, PF2.9, PG1.7, PG2.7, PH1.9, PH2.9, PJ1.9, PJ2.9, PK1.9, PK2.9, PL1.9, PL2.9, Q1.2 (E), R62.1, R96.2, S1.3 (K), S1.4 (A), U1.1 (VSS), U2.10, U3.11 (GND), U3.32 (GND1), U3.62 (GND2), U3.81 (GND3), U3.99 (AGND), U4.1 (VSS), U4.23 (~DCD), U4.24 (~CTS), U5.1 (VSS), U6.7 (GND), U7.7 (GND), U8.7 (GND), U9.1 (OE), U9.10 (GND), U10.10 (GND), U11.10 (GND), U12.7 (GND), U13.7 (GND), U14.14 (GND), U15.11 (GND), U15.26 (GND), U15.38 (GND), U15.43 (GND), U15.59 (GND), U15.74 (GND), U15.86 (GND), U15.95 (GND), U16.10 (GND), U17.10 (GND), U18.10 (GND), U19.11 (GND), U19.32 (GND1), U19.62 (GND2), U19.81 (GND3), U19.99 (AGND), U21.1 (OE), U21.10 (GND)
Gb: PH1.3, PH2.3, U3.14 (PH2(XCK2)), U19.14 (PH2(XCK2))
Gf: PH1.7, PH2.7, U3.18 (PH6(OC2B)), U19.18 (PH6(OC2B))
HSyncVGA_SuppressRCA: PB2.7, PB3.7, U3.25 ((OC1B/PCINT6)PB6), U19.25 ((OC1B/PCINT6)PB6)
Ib: PH1.1, PH2.1, U3.12 (PH0(RXD2)), U19.12 (PH0(RXD2))
If: PH1.5, PH2.5, U3.16 (PH4(OC4B)), U19.16 (PH4(OC4B))
Inside: PE1.7, PE2.7, U3.8 ((T3/INT6)PE6), U19.8 ((T3/INT6)PE6)
JT_TCK: U15.62 (I/O/TCK)
JT_TDI: U15.4 (I/O/TDI)
JT_TDO: U15.73 (I/O/TDO)
JT_TMS: U15.15 (I/O/TMS)
L0: M1.16 (A4), M4.16 (A4), TP17.1, TP25.1, U9.12 (Q7), U21.12 (Q7)
L1: M1.15 (A5), M4.15 (A5), TP18.1, TP26.1, U9.13 (Q6), U21.13 (Q6)
L2: M1.14 (A6), M4.14 (A6), TP19.1, TP27.1, U9.14 (Q5), U21.14 (Q5)
L3: M1.13 (A7), M4.13 (A7), TP20.1, TP28.1, U9.15 (Q4), U21.15 (Q4)
L4: M1.17 (A3), M4.17 (A3), TP21.1, TP29.1, U9.16 (Q3), U21.16 (Q3)
L5: M1.18 (A2), M4.18 (A2), TP22.1, TP30.1, U9.17 (Q2), U21.17 (Q2)
L6: M1.19 (A1), M4.19 (A1), TP23.1, TP41.1, U9.18 (Q1), U21.18 (Q1)
L7: M1.20 (A0), M4.20 (A0), TP24.1, TP42.1, U9.19 (Q0), U21.19 (Q0)
MISO: JP20.1 (A), JP55.1 (A), PB2.4, PB3.4, U3.22 ((MISO/PCINT3)PB3), U19.22 ((MISO/PCINT3)PB3)
MOSI: JP21.1 (A), JP56.1 (A), PB2.3, PB3.3, U3.21 ((MOSI/PCINT2)PB2), U19.21 ((MOSI/PCINT2)PB2)
MRDY: R52.1, TP33.1, U1.36 (MRDY), U15.78 (I/O)
MasterReset: J4.62, J6.62
unnamed: C1.2, U1.39 (XTAL), XTAL1.1
unnamed: C2.2, U1.38 (EXTAL), XTAL1.2
unnamed: Cx19.1, Cx20.1, Cx21.1, Cx22.1, R60.1, U12.2, U12.3, Y1.2
unnamed: Cx23.1, Cx24.1, Cx25.1, Cx26.1, R60.2, U12.1, Y1.1
unnamed: J7.1, TP2.1
unnamed: J7.2, TP3.1
unnamed: J7.3, TP4.1
unnamed: J7.4, TP5.1
unnamed: J7.5, TP6.1
unnamed: J7.6, TP7.1
unnamed: J7.7, TP8.1
unnamed: J7.8, TP1.1
unnamed: J7.9, TP16.1
unnamed: J7.10, TP15.1
unnamed: J7.11, TP14.1
unnamed: J7.12, TP13.1
unnamed: J7.13, TP12.1
unnamed: J7.14, TP11.1
unnamed: J7.15, TP10.1
unnamed: J7.16, TP9.1
unnamed: J8.1, JP19.2 (B), U19.100 (AVCC)
unnamed: J9.1, JP23.2 (B), U20.11
unnamed: J10.1, R39.2, U20.10
unnamed: J11.1, TP43.1
unnamed: J11.2, TP45.1
unnamed: J11.3, TP47.1
unnamed: J11.4, TP49.1
unnamed: J11.5, TP51.1
unnamed: J11.6, TP53.1
unnamed: J11.7, TP55.1
unnamed: J11.8, TP57.1
unnamed: J11.9, TP58.1
unnamed: J11.10, TP56.1
unnamed: J11.11, TP54.1
unnamed: J11.12, TP52.1
unnamed: J11.13, TP50.1
unnamed: J11.14, TP48.1
unnamed: J11.15, TP46.1
unnamed: J11.16, TP44.1
unnamed: J19.1, JP14.2 (B), U3.100 (AVCC)
unnamed: J34.1, JP12.2 (B), U2.11
unnamed: J35.1, R43.2, U2.10
unnamed: JP4.2 (B), TP37.1, U8.11
unnamed: JP5.2 (B), TP38.1, U8.9
unnamed: JP12.1 (A), JP13.1 (A), PE1.6, U3.7 ((OC3C/INT5)PE5)
unnamed: JP20.2 (B), R26.1
unnamed: JP21.2 (B), R27.1
unnamed: JP22.1 (A), JP23.1 (A), PE2.6, U19.7 ((OC3C/INT5)PE5)
unnamed: JP55.2 (B), R45.1
unnamed: JP56.2 (B), R44.1
unnamed: Jx1.2, U5.18 (CB1)
unnamed: Jx1.3, U13.5 (Q)
unnamed: Jx2.1, R95.1
unnamed: Jx2.3, R96.1
unnamed: L0.2 (A), R1.1
unnamed: L1.2 (A), R2.1
unnamed: L2.2 (A), R0.1
unnamed: L3.2 (A), R3.1
unnamed: L4.2 (A), R4.1
unnamed: L5.2 (A), R5.1
unnamed: L6.1 (K), R6.1
unnamed: L7.1 (K), R7.1
unnamed: L8.2 (A), R8.1
unnamed: L9.2 (A), R9.1
unnamed: L10.2 (A), R10.1
unnamed: L11.2 (A), R11.1
unnamed: L12.2 (A), R12.1
unnamed: L13.2 (A), R13.1
unnamed: L14.2 (A), R14.1
unnamed: L17.2 (A), R17.1
unnamed: L36.2 (A), R69.1
unnamed: L37.2 (A), R70.1
unnamed: L38.2 (A), R71.1
unnamed: L39.2 (A), R72.1
unnamed: L40.2 (A), R73.1
unnamed: L41.2 (A), R74.1
unnamed: L42.2 (A), R75.1
unnamed: L43.2 (A), R76.1
unnamed: L44.2 (A), R77.1
unnamed: L45.2 (A), R78.1
unnamed: L46.2 (A), R79.1
unnamed: L47.2 (A), R80.1
unnamed: L48.2 (A), R81.1
unnamed: L49.2 (A), R82.1
unnamed: L50.2 (A), R83.1
unnamed: L51.2 (A), R84.1
unnamed: L52.2 (A), R85.1
unnamed: L53.2 (A), R86.1
unnamed: L54.2 (A), R87.1
unnamed: L55.2 (A), R88.1
unnamed: L56.2 (A), R89.1
unnamed: L57.2 (A), R90.1
unnamed: L58.2 (A), R91.1
unnamed: L59.2 (A), R92.1
unnamed: LED1.2 (A), R39.1
unnamed: LED8.2 (A), R43.1
unnamed: LS1.2, Q1.3 (C)
unnamed: LSys1.1 (K), R62.2
unnamed: PA1.1, R69.2, U5.2 (PA0)
unnamed: PA1.2, R70.2, U5.3 (PA1)
unnamed: PA1.3, R71.2, U5.4 (PA2)
unnamed: PA1.4, R72.2, U5.5 (PA3)
unnamed: PA1.5, R73.2, U5.6 (PA4)
unnamed: PA1.6, R74.2, U5.7 (PA5)
unnamed: PA1.7, R75.2, U5.8 (PA6)
unnamed: PA1.8, R76.2, U5.9 (PA7)
unnamed: PB1.1, R77.2, U5.10 (PB0)
unnamed: PB1.2, R78.2, U5.11 (PB1)
unnamed: PB1.3, R79.2, U5.12 (PB2)
unnamed: PB1.4, R80.2, U5.13 (PB3)
unnamed: PB1.5, R81.2, U5.14 (PB4)
unnamed: PB1.6, R82.2, U5.15 (PB5)
unnamed: PB1.7, R83.2, U5.16 (PB6)
unnamed: PB1.8, R61.1, R84.2, U5.17 (PB7)
unnamed: PD1.5, R16.1, R18.1, U3.47 ((ICP1)PD4)
unnamed: PD1.6, U3.48 ((XCK1)PD5)
unnamed: PD2.5, R28.1, R30.1, U19.47 ((ICP1)PD4)
unnamed: PD2.6, U19.48 ((XCK1)PD5)
unnamed: Q1.1 (B), R61.2
unnamed: R0.2, U6.2
unnamed: R1.2, U6.6
unnamed: R2.2, U6.4
unnamed: R3.2, U6.8
unnamed: R4.2, U6.10
unnamed: R5.2, U6.12
unnamed: R6.2, U7.2
unnamed: R7.2, U7.4
unnamed: R8.2, U7.6
unnamed: R9.2, U7.8
unnamed: R10.2, U7.10
unnamed: R11.2, U7.12
unnamed: R12.2, U8.2
unnamed: R13.2, U8.4
unnamed: R14.2, U8.6
unnamed: R15.2, U10.20 (VCC)
unnamed: R17.2, U8.12
unnamed: R24.2, U18.20 (VCC)
unnamed: TP39.1, U8.10
unnamed: TP40.1, U8.8
PS2 Clock: R27.2, R44.2
PS2 Data: R26.2, R45.2
PS2-OE: PE1.3, PE2.3, U3.4 ((XCK0/AIN0)PE2), U19.4 ((XCK0/AIN0)PE2)
PSDat0: R16.1, R38.1
PSDat1: R19.1, R37.1
PSDat2: R18.1, R36.1
PSDat3: R19.1, R35.1
PSDat4: R20.1, R34.1
PSDat5: R21.1, R33.1
PSDat6: R22.1, R32.1
PSDat7: R23.1, R31.1
Q: TP36.1, U1.35 (Q), U15.90 (INPUT/OE2/GCLK2)
RD: M1.32 (~OE), M4.32 (~OE), PG1.2, PG2.2, U3.52 ((RD)PG1), U19.52 ((RD)PG1)
RTS0: PB2.6, PB3.6, U3.24 ((OC1A/PCINT5)PB5), U19.24 ((OC1A/PCINT5)PB5)
RX0: PE1.1, PE2.1, U3.2 ((RXD0/PCIN8)PE0), U19.2 ((RXD0/PCIN8)PE0)
Rb: PH1.4, PH2.4, U3.15 (PH3(OC4A)), U19.15 (PH3(OC4A))
Reset: U3.30 (RESET), U19.30 (RESET)
Rf: PH1.8, PH2.8, U3.27 (PH7(T4)), U19.27 (PH7(T4))
RomMapped: U6.11, U15.85 (I/O/GCLK3)
Rx: J3.1, R91.2, U4.2 (Rx_Data)
R~w: J4.54, J6.54, U1.32 (R/~W), U4.13 (R/~W), U5.21 (R/~W), U15.93 (I/O)
SCK: PB2.2, PB3.2, U3.20 ((SCK/PCINT1)PB1), U19.20 ((SCK/PCINT1)PB1)
SCL: PD1.1, PD2.1, U3.43 ((SCL/INT0)PD0), U19.43 ((SCL/INT0)PD0)
SDA: PD1.2, PD2.2, U3.44 ((SDA/INT1)PD1), U19.44 ((SDA/INT1)PD1)
SIGNAL_RCA: PD1.4, PD2.4, U3.46 ((TXD1/INT3)PD3), U19.46 ((TXD1/INT3)PD3)
SS: PB2.1, PB3.1, U3.19 ((SS/PCINT0)PB0), U19.19 ((SS/PCINT0)PB0)
Shared_Address_A0: M2.20 (A0), M5.20 (A0), PJ1.1, PJ2.1, U3.63 (PJ0(RXD3/PCINT9)), U11.2 (A0), U16.2 (A0), U19.63 (PJ0(RXD3/PCINT9))
Shared_Address_A1: M2.19 (A1), M5.19 (A1), PJ1.2, PJ2.2, U3.64 (PJ1(TXD3/PCINT10)), U11.3 (A1), U16.3 (A1), U19.64 (PJ1(TXD3/PCINT10))
Shared_Address_A2: M2.18 (A2), M5.18 (A2), PJ1.3, PJ2.3, U3.65 (PJ2(XCK3/PCINT11)), U11.4 (A2), U16.4 (A2), U19.65 (PJ2(XCK3/PCINT11))
Shared_Address_A3: M2.17 (A3), M5.17 (A3), PJ1.4, PJ2.4, U3.66 (PJ3(PCINT12)), U11.5 (A3), U16.5 (A3), U19.66 (PJ3(PCINT12))
Shared_Address_A4: M2.13 (A7), M5.13 (A7), PJ1.5, PJ2.5, U3.67 (PJ4(PCINT13)), U11.6 (A4), U16.6 (A4), U19.67 (PJ4(PCINT13))
Shared_Address_A5: M2.14 (A6), M5.14 (A6), PJ1.6, PJ2.6, U3.68 (PJ5(PCINT14)), U11.7 (A5), U16.7 (A5), U19.68 (PJ5(PCINT14))
Shared_Address_A6: M2.15 (A5), M5.15 (A5), PJ1.7, PJ2.7, U3.69 (PJ6(PCINT15)), U11.8 (A6), U16.8 (A6), U19.69 (PJ6(PCINT15))
Shared_Address_A7: M2.16 (A4), M5.16 (A4), PJ1.8, PJ2.8, U3.79 (PJ7), U11.9 (A7), U16.9 (A7), U19.79 (PJ7)
Shared_Address_A8: M2.1 (A11), M5.1 (A11), PK1.1, PK2.1, U2.2, U3.89 (PK0(ADC8/PCINT16)), U17.2 (A0), U19.89 (PK0(ADC8/PCINT16))
Shared_Address_A9: M2.2 (A9), M5.2 (A9), PK1.2, PK2.2, U2.3, U3.88 (PK1(ADC9/PCINT17)), U17.3 (A1), U19.88 (PK1(ADC9/PCINT17))
Shared_Address_A10: M2.3 (A8), M5.3 (A8), PK1.3, PK2.3, U2.4, U3.87 (PK2(ADC10/PCINT18)), U17.4 (A2), U19.87 (PK2(ADC10/PCINT18))
Shared_Address_A11: M2.4 (A13), M5.4 (A13), PK1.4, PK2.4, U2.5, U3.86 (PK3(ADC11/PCINT19)), U17.5 (A3), U19.86 (PK3(ADC11/PCINT19))
Shared_Address_A12: M2.7 (A15), M5.7 (A15), PK1.5, PK2.5, U2.6, U3.85 (PK4(ADC12/PCINT20)), U17.6 (A4), U19.85 (PK4(ADC12/PCINT20))
Shared_Address_A13: M2.11 (A14), M5.11 (A14), PK1.6, PK2.6, U2.7 (GND), U3.84 (PK5(ADC13/PCINT21)), U17.7 (A5), U19.84 (PK5(ADC13/PCINT21))
Shared_Address_A14: M2.12 (A12), M5.12 (A12), PK1.7, PK2.7, U2.8, U3.83 (PK6(ADC14/PCINT22)), U17.8 (A6), U19.83 (PK6(ADC14/PCINT22))
Shared_Address_A15: M2.31 (A10), M5.31 (A10), PK1.8, PK2.8, U2.9, U3.82 (PK7(ADC15/PCINT23)), U17.9 (A7), U19.82 (PK7(ADC15/PCINT23))
Shared_data_D0: M2.29 (DQ7), M5.29 (DQ7), PL1.1, PL2.1, U3.35 (PL0(ICP4)), U10.2 (A0), U18.2 (A0), U19.35 (PL0(ICP4))
Shared_data_D1: M2.28 (DQ6), M5.28 (DQ6), PL1.2, PL2.2, U3.36 (PL1(ICP5)), U10.3 (A1), U18.3 (A1), U19.36 (PL1(ICP5))
Shared_data_D2: M2.27 (DQ5), M5.27 (DQ5), PL1.3, PL2.3, U3.37 (PL2(T5)), U10.4 (A2), U18.4 (A2), U19.37 (PL2(T5))
Shared_data_D3: M2.26 (DQ4), M5.26 (DQ4), PL1.4, PL2.4, U3.38 (PL3(OC5A)), U10.5 (A3), U18.5 (A3), U19.38 (PL3(OC5A))
Shared_data_D4: M2.25 (DQ3), M5.25 (DQ3), PL1.5, PL2.5, U3.39 (PL4(OC5B)), U10.6 (A4), U18.6 (A4), U19.39 (PL4(OC5B))
Shared_data_D5: M2.23 (DQ2), M5.23 (DQ2), PL1.6, PL2.6, U3.40 (PL5(OC5C)), U10.7 (A5), U18.7 (A5), U19.40 (PL5(OC5C))
Shared_data_D6: M2.22 (DQ1), M5.22 (DQ1), PL1.7, PL2.7, U3.41 (PL6), U10.8 (A6), U18.8 (A6), U19.41 (PL6)
Shared_data_D7: M2.21 (DQ0), M5.21 (DQ0), PL1.8, PL2.8, U3.42 (PL7), U10.9 (A7), U18.9 (A7), U19.42 (PL7)
TX0: PE1.2, PE2.2, U3.3 ((TXD0)PE1), U19.3 ((TXD0)PE1)
Tx: J3.2, R92.2, U4.6 (Tx_Data)
VGA Latch: PB2.8, PB3.8, U3.26 ((OC0A/OC1C/PCINT7)PB7), U19.26 ((OC0A/OC1C/PCINT7)PB7)
VGA data 0: PF1.1, PF2.1, R16.2, R38.2, U3.97 ((ADC0)PF0), U19.97 ((ADC0)PF0)
VGA data 1: PF1.2, PF2.2, R19.2, R37.2, U3.96 ((ADC1)PF1), U19.96 ((ADC1)PF1)
VGA data 2: PF1.3, PF2.3, R18.2, R36.2, U3.95 ((ADC2)PF2), U19.95 ((ADC2)PF2)
VGA data 3: PF1.4, PF2.4, R19.2, R35.2, U3.94 ((ADC3)PF3), U19.94 ((ADC3)PF3)
VGA data 4: PF1.5, PF2.5, R20.2, R34.2, U3.93 ((ADC4/TCK)PF4), U19.93 ((ADC4/TCK)PF4)
VGA data 5: PF1.6, PF2.6, R21.2, R33.2, U3.92 ((ADC5/TMS)PF5), U19.92 ((ADC5/TMS)PF5)
VGA data 6: PF1.7, PF2.7, R22.2, R32.2, U3.91 ((ADC6/TDO)PF6), U19.91 ((ADC6/TDO)PF6)
VGA data 7: PF1.8, PF2.8, R23.2, R31.2, U3.90 ((ADC7/TDI)PF7), U19.90 ((ADC7/TDI)PF7)
VSyncVGA_RCA: PE1.5, PE2.5, U3.6 ((OC3B/INT4)PE4), U19.6 ((OC3B/INT4)PE4)
WE: M1.5 (~WE), M4.5 (~WE), PG1.1, PG2.1, U3.51 ((WR)PG0), U19.51 ((WR)PG0)
XAA0: M1.1 (A11), M4.1 (A11), PC1.1, PC2.1, U3.53 ((A8)PC0), U19.53 ((A8)PC0)
XAA1: M1.2 (A9), M4.2 (A9), PC1.2, PC2.2, U3.54 ((A9)PC1), U19.54 ((A9)PC1)
XAA2: M1.3 (A8), M4.3 (A8), PC1.3, PC2.3, U3.55 ((A10)PC2), U19.55 ((A10)PC2)
XAA3: M1.4 (A13), M4.4 (A13), PC1.4, PC2.4, U3.56 ((A11)PC3), U19.56 ((A11)PC3)
XAA4: M1.7 (A15), M4.7 (A15), PC1.5, PC2.5, U3.57 ((A12)PC4), U19.57 ((A12)PC4)
XAA5: M1.11 (A14), M4.11 (A14), PC1.6, PC2.6, U3.58 ((A13)PC5), U19.58 ((A13)PC5)
XAA6: M1.12 (A12), M4.12 (A12), PC1.7, PC2.7, U3.59 ((A14)PC6), U19.59 ((A14)PC6)
XAA7: M1.31 (A10), M4.31 (A10), PC1.8, PC2.8, U3.60 ((A15)PC7), U19.60 ((A15)PC7)
XAD0: M1.21 (DQ0), M1.28 (DQ6), M4.21 (DQ0), M4.28 (DQ6), PA2.1, PA2.7, PA3.1, PA3.7, U3.72 ((AD6)PA6), U3.78 ((AD0)PA0), U9.3 (D1), U9.9 (D7), U19.72 ((AD6)PA6), U19.78 ((AD0)PA0), U21.3 (D1), U21.9 (D7)
XAD1: M1.22 (DQ1), M1.27 (DQ5), M4.22 (DQ1), M4.27 (DQ5), PA2.2, PA2.6, PA3.2, PA3.6, U3.73 ((AD5)PA5), U3.77 ((AD1)PA1), U9.4 (D2), U9.8 (D6), U19.73 ((AD5)PA5), U19.77 ((AD1)PA1), U21.4 (D2), U21.8 (D6)
XAD2: M1.23 (DQ2), M1.26 (DQ4), M4.23 (DQ2), M4.26 (DQ4), PA2.3, PA2.5, PA3.3, PA3.5, U3.74 ((AD4)PA4), U3.76 ((AD2)PA2), U9.5 (D3), U9.7 (D5), U19.74 ((AD4)PA4), U19.76 ((AD2)PA2), U21.5 (D3), U21.7 (D5)
XAD3: M1.25 (DQ3), M4.25 (DQ3), PA2.4, PA3.4, U3.75 ((AD3)PA3), U9.6 (D4), U19.75 ((AD3)PA3), U21.6 (D4)
XAD7: M1.29 (DQ7), M4.29 (DQ7), PA2.8, PA3.8, U3.71 ((AD7)PA7), U9.2 (D0), U19.71 ((AD7)PA7), U21.2 (D0)
XTAL1: C4.2, C13.2, J2.1, J18.1, R25.1, R29.1, U3.33 (XTAL2), U19.33 (XTAL2), Y2.2, Y3.2
XTAL2: C6.2, C14.2, J5.1, J16.1, R25.2, R29.2, U3.34 (XTAL1), U19.34 (XTAL1), Y2.1, Y3.1
vCA1: Jx4.1, R90.2, U5.40 (CA1)
vCA2: Jx4.2, R89.2, U5.39 (CA2)
vCB1: Jx1.1, Jx4.3, R88.2, U13.2 (D)
vCB2: Jx4.4, R87.2, U5.19 (CB2)
v~IRQA: Jx4.5, R86.2, U5.38 (~IRQA)
v~IRQB: Jx4.6, R85.2, U5.37 (~IRQB)
~DMA_BREQ: R51.1, TP32.1, U1.33 (~DMA/BREQ), U15.79 (I/O)
~Dev_1: J4.58, J6.58
~Dev_2: J4.59, J6.59
~Dev_3: J4.60, J6.60
~Dev_4: J4.61, J6.61
~Dev_FIRQ: J4.57, J6.57, R50.1, U1.4 (~FIRQ), U15.80 (I/O)
~Dev_IRQ: J4.56, J6.56, R49.1, U1.3 (~IRQ), U4.7 (~IRQ), U15.81 (I/O)
~Dev_NMI: J4.55, J6.55, R48.1, U1.2 (~NMI), U15.83 (I/O)
~Dev_Sel_1: R53.1, U5.23 (~CS2), U7.13, U15.68 (I/O)
~Dev_Sel_2: R54.1, U4.9 (CS2), U7.11, U15.69 (I/O)
~Dev_Sel_3: R55.1, U7.9, U15.70 (I/O)
~Dev_Sel_4: R56.1, U8.5, U15.71 (I/O)
~Dev_Sel_5: R57.1, U8.3, U15.72 (I/O)
~Dev_Sel_6: R58.1, U8.1, U15.75 (I/O)
~Dev_Sel_7: R59.1, TP31.1, U8.13, U15.76 (I/O)
~HALT: R63.2, U1.40 (~HALT), U6.3, U15.92 (I/O)
~RAM_Sel: M3.30 (~CS1/~CE1), R98.1, U7.5, U15.67 (I/O)
~ROM_Sel: R99.1, U6.9, U14.20 (~CS), U15.65 (I/O)
~Read: M3.32 (~OE), U14.22 (~OE), U15.63 (I/O)
~Reset: C12.1, D2.2 (A), J12.1, R64.2, S1.1, S1.2, U1.37 (~RESET), U5.34 (~RESET), U6.5, U15.89 (INPUT/GCLR)
~VGA_Enable: PD1.3, PD2.3, U3.45 ((RXD1/INT2)PD2), U19.45 ((RXD1/INT2)PD2)
~Write: M3.5 (~WE), U14.27 (~WE), U15.64 (I/O)

Notes on the sheet:
RAM_Sel
RX for Signal_RCA
External RAM_Sel for Arduino
Dev 0
60+2+2
ACIA
Dev_0 RAM_Sel
10-20 Ohm, or diode for restricting voltage and lowering ViH under 3.4V
ATMEGA A[8..15]
GLUE
OUT
VIA
ATF - 1
SCK for Signal_RCA
ROM
CPU
Shared Memory
~Reset, Dev_NMI, Dev_IRQ, Dev_FIRQ,E,R~{w}
MHF_A
I2C style pullup
SystemRAM
PULLUPS
TESTPOINTS
5 E, R/~W ~Reset, HALT, BA
MHF_B
VGA Colors
For future use maybe
PB7 is usual Arduino Mega SYSTEM_LED - with VGA it will shine full time
ATMEGA A[0..7]
ATMEGA D[0..7]
SYSTEM LEDs
HD6309
ROM_Sel
2x MHF-002
Dev X
EMS RAM_Sel 8000-9FFF A000-BFFFF (shared between Arduino and HD6309)
Dev_Sel_0 = RAM_Sel Dev_Sel_1 = OnBoard VIA Dev_Sel_2 = OnBoard ACIA Dev_Sel_3 = Bus_1 Dev_Sel_4 = Bus_2 Dev_Sel_5 = Bus_3 Dev_Sel_6 = Bus_4 Dev_Sel_7 = OnBoard future use
CONFIG
6309 memory regions
A020..A0FF
TYP
Memory mapped devices (? 15 x 16 B?)
A100..FFFF
6 GLUE registers (xxx = regnum)
0000..7FFF
0011
EMS1 4K
0000
0001
1xxx
8000..8FFF
A000..A01F
Native RAM_Sel 32K
9000..9FFF
0100
CONTENT
0010
EMS2 4K
Native RAM_Sel ~ ROM_Sel 23.75K
RANGE
