githubgilhad/HW-001/PLD/SOviewer/retro-003.kicad_sch

## KiCad design PLD/SOviewer/retro-003.kicad_sch (2026-09-03)

Schematic: retro-003.kicad_sch

Parts:
C1, C2: 20p; C_Disc_D5.0mm_W2.5mm_P2.50mm
C12: 100n Reset; C_Disc_D3.0mm_W2.0mm_P2.50mm
Cx6, Cx7, Cx8, Cx9, Cx10, Cx11, Cx12, Cx13, Cx16, Cx17, Cx18: Cx; C_Disc_D3.0mm_W2.0mm_P2.50mm
Cx14, Cx15, Cx27, Cx28: Cx; CP_Radial_D5.0mm_P2.50mm
Cx19, Cx20, Cx21, Cx22, Cx23, Cx24, Cx25, Cx26: 10p; C_Disc_D3.0mm_W2.0mm_P2.50mm
D2: D; D_1210_3225Metric_HandSolder
H5, H6, H7, H8: MountingHole; MountingHole_3.2mm_M3_Pad
J1: ATF_JTAG; IDC-Header_2x05_P2.54mm_Vertical
J2: Conn_02x04_Top_Bottom; PinSocket_2x04_P2.54mm_Vertical
J3: Serial; PinHeader_1x04_P2.54mm_Vertical
J4: SysBus; PinSocket_2x32_P2.54mm_Vertical
J5, J8, J21, J22, J37, J38, J39, J40, J41, J42, J43, J44, J45, J46, J47, J48, J49, J50, J51, J52, J53, J54, J55, J56, J57, J58, J59, J60, J61, J62, J63, J64, J65, J66, J67, J68, J69, J70, J71, J72, J73, J74, J75, J76, J77, J78, J79, J80, J81, J82, J83, J84, J85, J86, J87, J88, J89, J90, J91, J92, J93, J94, J95, J96, J97, J98, J99, J100, J101, J102, J103, J104, J105, J106: x; PinHole_1x01_2.54xrectangle
J6: SysBus; PinHeader_2x32_P2.54mm_Vertical_down
J7: Conn_01x16_Pin; G_SOIC-16_3.9x9.9mm_HandSolder
J12: Reset; PinHole_1x01_2.54xrectangle
JP1: Nx4; SolderJumper-2_P1.3mm_Bridged_Pad1.0x1.5mm
JP2: Nx5; SolderJumper-2_P1.3mm_Bridged_Pad1.0x1.5mm
JP3: Nx6; SolderJumper-2_P1.3mm_Bridged_Pad1.0x1.5mm
JP4: Nx1; SolderJumper-2_P1.3mm_Bridged_Pad1.0x1.5mm
JP5: Nx2; SolderJumper-2_P1.3mm_Bridged_Pad1.0x1.5mm
JP13: Nx3; SolderJumper-2_P1.3mm_Bridged_Pad1.0x1.5mm
Jx1: BugFix; PinHeader_1x03_P2.54mm_Vertical
Jx2: BootFrom; PinHeader_1x03_P2.54mm_Vertical
Jx4: J; PinHeader_1x08_P2.54mm_Vertical
L0: LReset; LED_0805_2012Metric
L1: LHALT; LED_0805_2012Metric
L2: A_HALT; LED_0805_2012Metric
L3: ROM; LED_0805_2012Metric
L4: LRomMapped; LED_0805_2012Metric
L5: B_HALT; LED_0805_2012Metric
L6: MHF_B; LED_0805_2012Metric
L7: MHF_A; LED_0805_2012Metric
L8: RAM; LED_0805_2012Metric
L9: Dev_3; LED_0805_2012Metric
L10: ACIA; LED_0805_2012Metric
L11: VIA; LED_0805_2012Metric
L12: Dev_6; LED_0805_2012Metric
L13: Dev_5; LED_0805_2012Metric
L14: Dev_4; LED_0805_2012Metric
L17: Dev_7; LED_0805_2012Metric
L36: A0; LED_0805_2012Metric
L37, L57: A1; LED_0805_2012Metric
L38, L56: A2; LED_0805_2012Metric
L39: A3; LED_0805_2012Metric
L40: A4; LED_0805_2012Metric
L41: A5; LED_0805_2012Metric
L42: A6; LED_0805_2012Metric
L43: A7; LED_0805_2012Metric
L44: B0; LED_0805_2012Metric
L45, L55: B1; LED_0805_2012Metric
L46, L54: B2; LED_0805_2012Metric
L47: B3; LED_0805_2012Metric
L48: B4; LED_0805_2012Metric
L49: B5; LED_0805_2012Metric
L50: B6; LED_0805_2012Metric
L51: B7; LED_0805_2012Metric
L52: IA; LED_0805_2012Metric
L53: IB; LED_0805_2012Metric
L58: Rx; LED_0805_2012Metric
L59: Tx; LED_0805_2012Metric
LS1: Speaker_Crystal; Buzzer_12x9.5RM7.6
LSys1: Sys; LED_0805_2012Metric
M3: CY7C109D-10ZXI; G_TSOP-I-32_18.4x8mm_HandSolder
PA1: J; PinHeader_1x10_P2.54mm_Vertical
PB1: J; PinHeader_1x10_P2.54mm_Vertical
Q1: MMBT3904; SOT-23
R0, R1, R2, R3, R4, R5, R6, R7, R8, R9, R10, R11, R12, R13, R14, R17, R61, R62, R69, R70, R71, R72, R73, R74, R75, R76, R77, R78, R79, R80, R81, R82, R83, R84, R85, R86, R87, R88, R89, R90, R91, R92: 1k; R_0805_2012Metric_Pad1.20x1.40mm_HandSolder
R36, R37, R38, R39, R44, R45, R46, R47: 5k8; R_0805_2012Metric
R40, R41, R42, R43: 220; R_0805_2012Metric
R48, R49, R50, R51, R52, R53, R54, R55, R56, R57, R58, R59, R64, R95, R96, R98, R99, R100, R102: 10k; R_0805_2012Metric_Pad1.20x1.40mm_HandSolder
R60: 1M; R_0805_2012Metric_Pad1.20x1.40mm_HandSolder
R63: 3k3; R_0805_2012Metric_Pad1.20x1.40mm_HandSolder
R93, R94: 50k; R_0805_2012Metric_Pad1.20x1.40mm_HandSolder
S1: Reset; G_Arduino_switch; PARTREV 1.0
TP1, TP16: 7; TestPoint_Pad_1.0x1.0mm
TP2, TP9: 0; TestPoint_Pad_1.0x1.0mm
TP3, TP10: 1; TestPoint_Pad_1.0x1.0mm
TP4, TP11: 2; TestPoint_Pad_1.0x1.0mm
TP5, TP12: 3; TestPoint_Pad_1.0x1.0mm
TP6, TP13: 4; TestPoint_Pad_1.0x1.0mm
TP7, TP14: 5; TestPoint_Pad_1.0x1.0mm
TP8, TP15: 6; TestPoint_Pad_1.0x1.0mm
TP17: D; TestPoint_Pad_1.0x1.0mm
TP18: Clk; TestPoint_Pad_1.0x1.0mm
TP19, TP36: Q; TestPoint_Pad_1.0x1.0mm
TP20: ~{Q}; TestPoint_Pad_1.0x1.0mm
TP21: ~{R}; TestPoint_Pad_1.0x1.0mm
TP22: ~{S}; TestPoint_Pad_1.0x1.0mm
TP23: N3; TestPoint_Pad_1.0x1.0mm
TP24: N4; TestPoint_Pad_1.0x1.0mm
TP25: N5; TestPoint_Pad_1.0x1.0mm
TP26: N6; TestPoint_Pad_1.0x1.0mm
TP27: ~{N3}; TestPoint_Pad_1.0x1.0mm
TP28: ~{N4}; TestPoint_Pad_1.0x1.0mm
TP29: ~{N5}; TestPoint_Pad_1.0x1.0mm
TP30: ~{N6}; TestPoint_Pad_1.0x1.0mm
TP31: DEV7; TestPoint_Pad_1.0x1.0mm
TP32: DMA; TestPoint_Pad_1.0x1.0mm
TP33: MRDY; TestPoint_Pad_1.0x1.0mm
TP34: BA; TestPoint_Pad_1.0x1.0mm
TP35: BS; TestPoint_Pad_1.0x1.0mm
TP37: N1; TestPoint_Pad_1.0x1.0mm
TP38: N2; TestPoint_Pad_1.0x1.0mm
TP39: ~{N1}; TestPoint_Pad_1.0x1.0mm
TP40: ~{N2}; TestPoint_Pad_1.0x1.0mm
U1: HD6309; DIP-40_W15.24mm
U4: MC68B50; DIP-24_W15.24mm
U5: 6822; DIP-40_W15.24mm
U6, U7, U8: 74HC14; SOIC-14_3.9x8.7mm_P1.27mm
U12: 74HC04; SOIC-14_3.9x8.7mm_P1.27mm
U13: 74HC74; SOIC-14_3.9x8.7mm_P1.27mm
U14: 28C256; DIP-28_W15.24mm
U15: ATF1508AS-10AU100; ATF1508-AS_TQFP100_long
XTAL1: 16MHz; Crystal_HC49-4H_Vertical
Y1: 1.8432 MHz; Crystal_THT_15_5mm

Connections:
+5V: Cx6.1, Cx7.1, Cx8.1, Cx9.1, Cx10.1, Cx11.1, Cx12.1, Cx13.1, Cx14.1, Cx15.1, Cx16.1, Cx17.1, Cx18.1, Cx27.1, Cx28.1, D2.1 (K), J1.4 (Vcc), J2.1, J2.3, J2.5, J2.7, J3.4, J4.1, J4.2, J5.1, J6.1, J6.2, Jx4.8, L6.2 (A), L7.2 (A), LS1.1, LSys1.2 (A), M3.6 (CS2/CE2), M3.8 (VCC), PA1.10, PB1.10, R36.2, R37.2, R38.2, R39.2, R48.2, R49.2, R50.2, R51.2, R52.2, R53.2, R54.2, R55.2, R56.2, R57.2, R58.2, R59.2, R63.1, R64.1, R93.1, R94.1, R95.2, R98.2, R99.2, R100.2, R102.2, U1.7 (VCC), U4.8 (CS0), U4.10 (CS1), U4.12 (VCC), U5.20 (VCC), U5.22 (CS0), U5.24 (CS1), U6.14 (VCC), U7.14 (VCC), U8.14 (VCC), U12.14 (VCC), U13.1 (~R), U13.4 (~S), U13.14 (VCC), U14.28 (VCC), U15.3 (VCCIO), U15.18 (VCCIO), U15.34 (VCCIO), U15.39 (VCCINT), U15.51 (VCCIO), U15.66 (VCCIO), U15.82 (VCCIO), U15.91 (VCCINT)
A0: J4.11, J6.11
A1: J4.12, J6.12
A2: J4.13, J6.13
A3: J4.14, J6.14
A4: J4.15, J6.15
A5: J4.16, J6.16
A6: J4.17, J6.17
A7: J4.18, J6.18
A8: J4.19, J6.19
A9: J4.20, J6.20
A10: J4.21, J6.21
A11: J4.22, J6.22
A12: J4.23, J6.23
A13: J4.24, J6.24
A14: J4.25, J6.25
A15: J4.26, J6.26
ACIA Clk 1.8432 MHz: U4.3 (Rx_CLK), U4.4 (Tx_CLK), U12.4
A_G_A_DIR: J4.47, J6.47
A_G_D_DIR: J4.49, J6.49
A_G_ENABLE: J4.45, J6.45
A_HALT: J4.29, J6.29
A_READ: J4.31, J6.31
A_SHARE_DIRTY: J4.33, J6.33
A_SHARE_GRANTED: J4.35, J6.35, U7.3
A_SHARE_REQUEST: J4.37, J6.37
A_SHARE_SELECT: J4.51, J6.51
A_S_16: J4.27, J6.27, R100.1
A_S_READ: J4.41, J6.41
A_S_SELECT: J4.39, J6.39
A_S_WRITE: J4.43, J6.43
BA: TP34.1, U1.6 (BA), U15.88 (12V/INPUT/OE1)
BS: TP35.1, U1.5 (BS), U15.77 (I/O)
B_G_A_DIR: J4.48, J6.48
B_G_D_DIR: J4.50, J6.50
B_G_ENABLE: J4.46, J6.46
B_HALT: J4.30, J6.30
B_READ: J4.32, J6.32
B_SHARE_DIRTY: J4.34, J6.34
B_SHARE_GRANTED: J4.36, J6.36, U7.1
B_SHARE_REQUEST: J4.38, J6.38
B_SHARE_SELECT: J4.52, J6.52
B_S_16: J4.28, J6.28, R102.1
B_S_READ: J4.42, J6.42
B_S_SELECT: J4.40, J6.40
B_S_WRITE: J4.44, J6.44
BootSrc: Jx2.2, U15.84 (I/O)
CA0: M3.20 (A0), U1.8 (A0), U4.11 (RS), U5.36 (RS0), U14.10 (A0), U15.5 (I/O)
CA1: M3.19 (A1), U1.9 (A1), U5.35 (RS1), U14.9 (A1), U15.6 (I/O)
CA2: M3.18 (A2), U1.10 (A2), U14.8 (A2), U15.7 (I/O)
CA3: M3.17 (A3), U1.11 (A3), U14.7 (A3), U15.8 (I/O)
CA4: M3.16 (A4), U1.12 (A4), U14.6 (A4), U15.9 (I/O)
CA5: M3.15 (A5), U1.13 (A5), U14.5 (A5), U15.10 (I/O)
CA6: M3.14 (A6), U1.14 (A6), U14.4 (A6), U15.12 (I/O)
CA7: M3.13 (A7), U1.15 (A7), U14.3 (A7), U15.13 (I/O)
CA8: M3.3 (A8), U1.16 (A8), U14.25 (A8), U15.14 (I/O)
CA9: M3.2 (A9), U1.17 (A9), U14.24 (A9), U15.16 (I/O)
CA10: M3.31 (A10), U1.18 (A10), U14.21 (A10), U15.17 (I/O)
CA11: M3.1 (A11), U1.19 (A11), U14.23 (A11), U15.19 (I/O)
CA12: U1.20 (A12), U15.20 (I/O)
CA13: U1.21 (A13), U15.21 (I/O)
CA14: U1.22 (A14), U15.22 (I/O)
CA15: U1.23 (A15), U15.23 (I/O)
D0: J4.3, J6.3, M3.21 (DQ0), U1.31 (D0), U4.22 (D0), U5.33 (D0), U14.11 (D0), U15.94 (I/O)
D1: J4.4, J6.4, M3.22 (DQ1), U1.30 (D1), U4.21 (D1), U5.32 (D1), U14.12 (D1), U15.96 (I/O)
D2: J4.5, J6.5, M3.23 (DQ2), U1.29 (D2), U4.20 (D2), U5.31 (D2), U14.13 (D2), U15.97 (I/O)
D3: J4.6, J6.6, M3.25 (DQ3), U1.28 (D3), U4.19 (D3), U5.30 (D3), U14.15 (D3), U15.98 (I/O)
D4: J4.7, J6.7, M3.26 (DQ4), U1.27 (D4), U4.18 (D4), U5.29 (D4), U14.16 (D4), U15.99 (I/O)
D5: J4.8, J6.8, M3.27 (DQ5), U1.26 (D5), U4.17 (D5), U5.28 (D5), U14.17 (D5), U15.100 (I/O)
D6: J4.9, J6.9, M3.28 (DQ6), U1.25 (D6), U4.16 (D6), U5.27 (D6), U14.18 (D6), U15.1 (PD1/I/O)
D7: J4.10, J6.10, M3.29 (DQ7), U1.24 (D7), U4.15 (D7), U5.26 (D7), U14.19 (D7), U15.2 (I/O)
Dev_E: J4.53, J6.53
Dev_R~W: J4.54, J6.54
E: U1.34 (E), U4.14 (E), U5.25 (ENABLE), U13.3 (C), U15.87 (INPUT/GCLK1)
GA12: M3.12 (A12), U14.2 (A12), U15.61 (I/O)
GA13: M3.4 (A13), U14.26 (A13), U15.60 (I/O)
GA14: M3.11 (A14), U14.1 (A14), U15.58 (I/O)
GA15: M3.7 (A15), U15.57 (I/O)
GA16: M3.10 (A16), U15.56 (I/O)
GND: C1.1, C2.1, C12.2, Cx6.2, Cx7.2, Cx8.2, Cx9.2, Cx10.2, Cx11.2, Cx12.2, Cx13.2, Cx14.2, Cx15.2, Cx16.2, Cx17.2, Cx18.2, Cx19.2, Cx20.2, Cx21.2, Cx22.2, Cx23.2, Cx24.2, Cx25.2, Cx26.2, Cx27.2, Cx28.2, J1.2 (GND), J1.10 (GND), J2.2, J2.4, J2.6, J2.8, J3.3, J4.63, J4.64, J6.63, J6.64, J8.1, JP1.1 (A), JP2.1 (A), JP3.1 (A), JP4.1 (A), JP5.1 (A), JP13.1 (A), Jx4.7, L0.1 (K), L1.1 (K), L2.1 (K), L3.1 (K), L4.1 (K), L5.1 (K), L8.1 (K), L9.1 (K), L10.1 (K), L11.1 (K), L12.1 (K), L13.1 (K), L14.1 (K), L17.1 (K), L36.1 (K), L37.1 (K), L38.1 (K), L39.1 (K), L40.1 (K), L41.1 (K), L42.1 (K), L43.1 (K), L44.1 (K), L45.1 (K), L46.1 (K), L47.1 (K), L48.1 (K), L49.1 (K), L50.1 (K), L51.1 (K), L52.1 (K), L53.1 (K), L54.1 (K), L55.1 (K), L56.1 (K), L57.1 (K), L58.1 (K), L59.1 (K), M3.24 (GND), PA1.9, PB1.9, Q1.2 (E), R44.1, R45.1, R46.1, R47.1, R62.1, R96.2, S1.3 (K), S1.4 (A), U1.1 (VSS), U4.1 (VSS), U4.23 (~DCD), U4.24 (~CTS), U5.1 (VSS), U6.7 (GND), U7.7 (GND), U8.7 (GND), U12.7 (GND), U13.7 (GND), U14.14 (GND), U15.11 (GND), U15.26 (GND), U15.38 (GND), U15.43 (GND), U15.59 (GND), U15.74 (GND), U15.86 (GND), U15.95 (GND)
JT_TCK: R36.1, R40.1, R44.2, U15.62 (I/O/TCK)
JT_TDI: R39.1, R43.1, R47.2, U15.4 (I/O/TDI)
JT_TDO: R37.1, R41.1, R45.2, U15.73 (I/O/TDO)
JT_TMS: R38.1, R42.1, R46.2, U15.15 (I/O/TMS)
MRDY: R52.1, TP33.1, U1.36 (MRDY), U15.78 (I/O)
MasterReset: J4.62, J6.62
unnamed: C1.2, U1.39 (XTAL), XTAL1.1
unnamed: C2.2, U1.38 (EXTAL), XTAL1.2
unnamed: Cx19.1, Cx20.1, Cx21.1, Cx22.1, R60.1, U12.2, U12.3, Y1.2
unnamed: Cx23.1, Cx24.1, Cx25.1, Cx26.1, R60.2, U12.1, Y1.1
unnamed: J1.1 (TCK), R40.2
unnamed: J1.3 (TDO), R41.2
unnamed: J1.5 (TMS), R42.2
unnamed: J1.9 (TDI), R43.2
unnamed: J7.1, TP2.1
unnamed: J7.2, TP3.1
unnamed: J7.3, TP4.1
unnamed: J7.4, TP5.1
unnamed: J7.5, TP6.1
unnamed: J7.6, TP7.1
unnamed: J7.7, TP8.1
unnamed: J7.8, TP1.1
unnamed: J7.9, TP16.1
unnamed: J7.10, TP15.1
unnamed: J7.11, TP14.1
unnamed: J7.12, TP13.1
unnamed: J7.13, TP12.1
unnamed: J7.14, TP11.1
unnamed: J7.15, TP10.1
unnamed: J7.16, TP9.1
unnamed: JP1.2 (B), TP24.1, U12.9
unnamed: JP2.2 (B), TP25.1, U12.11
unnamed: JP3.2 (B), TP26.1, U12.13
unnamed: JP4.2 (B), TP37.1, U8.11
unnamed: JP5.2 (B), TP38.1, U8.9
unnamed: JP13.2 (B), TP23.1, U12.5
unnamed: Jx1.2, U5.18 (CB1)
unnamed: Jx1.3, U13.5 (Q)
unnamed: Jx2.1, R95.1
unnamed: Jx2.3, R96.1
unnamed: L0.2 (A), R1.1
unnamed: L1.2 (A), R2.1
unnamed: L2.2 (A), R0.1
unnamed: L3.2 (A), R3.1
unnamed: L4.2 (A), R4.1
unnamed: L5.2 (A), R5.1
unnamed: L6.1 (K), R6.1
unnamed: L7.1 (K), R7.1
unnamed: L8.2 (A), R8.1
unnamed: L9.2 (A), R9.1
unnamed: L10.2 (A), R10.1
unnamed: L11.2 (A), R11.1
unnamed: L12.2 (A), R12.1
unnamed: L13.2 (A), R13.1
unnamed: L14.2 (A), R14.1
unnamed: L17.2 (A), R17.1
unnamed: L36.2 (A), R69.1
unnamed: L37.2 (A), R70.1
unnamed: L38.2 (A), R71.1
unnamed: L39.2 (A), R72.1
unnamed: L40.2 (A), R73.1
unnamed: L41.2 (A), R74.1
unnamed: L42.2 (A), R75.1
unnamed: L43.2 (A), R76.1
unnamed: L44.2 (A), R77.1
unnamed: L45.2 (A), R78.1
unnamed: L46.2 (A), R79.1
unnamed: L47.2 (A), R80.1
unnamed: L48.2 (A), R81.1
unnamed: L49.2 (A), R82.1
unnamed: L50.2 (A), R83.1
unnamed: L51.2 (A), R84.1
unnamed: L52.2 (A), R85.1
unnamed: L53.2 (A), R86.1
unnamed: L54.2 (A), R87.1
unnamed: L55.2 (A), R88.1
unnamed: L56.2 (A), R89.1
unnamed: L57.2 (A), R90.1
unnamed: L58.2 (A), R91.1
unnamed: L59.2 (A), R92.1
unnamed: LS1.2, Q1.3 (C)
unnamed: LSys1.1 (K), R62.2
unnamed: PA1.1, R69.2, U5.2 (PA0)
unnamed: PA1.2, R70.2, U5.3 (PA1)
unnamed: PA1.3, R71.2, U5.4 (PA2)
unnamed: PA1.4, R72.2, U5.5 (PA3)
unnamed: PA1.5, R73.2, U5.6 (PA4)
unnamed: PA1.6, R74.2, U5.7 (PA5)
unnamed: PA1.7, R75.2, U5.8 (PA6)
unnamed: PA1.8, R76.2, U5.9 (PA7)
unnamed: PB1.1, R77.2, U5.10 (PB0)
unnamed: PB1.2, R78.2, U5.11 (PB1)
unnamed: PB1.3, R79.2, U5.12 (PB2)
unnamed: PB1.4, R80.2, U5.13 (PB3)
unnamed: PB1.5, R81.2, U5.14 (PB4)
unnamed: PB1.6, R82.2, U5.15 (PB5)
unnamed: PB1.7, R83.2, U5.16 (PB6)
unnamed: PB1.8, R61.1, R84.2, U5.17 (PB7)
unnamed: Q1.1 (B), R61.2
unnamed: R0.2, U6.2
unnamed: R1.2, U6.6
unnamed: R2.2, U6.4
unnamed: R3.2, U6.8
unnamed: R4.2, U6.10
unnamed: R5.2, U6.12
unnamed: R6.2, U7.2
unnamed: R7.2, U7.4
unnamed: R8.2, U7.6
unnamed: R9.2, U7.8
unnamed: R10.2, U7.10
unnamed: R11.2, U7.12
unnamed: R12.2, U8.2
unnamed: R13.2, U8.4
unnamed: R14.2, U8.6
unnamed: R17.2, U8.12
unnamed: TP17.1, U13.12 (D)
unnamed: TP18.1, U13.11 (C)
unnamed: TP19.1, U13.9 (Q)
unnamed: TP20.1, U13.8 (~Q)
unnamed: TP21.1, U13.13 (~R)
unnamed: TP22.1, U13.10 (~S)
unnamed: TP27.1, U12.6
unnamed: TP28.1, U12.8
unnamed: TP29.1, U12.10
unnamed: TP30.1, U12.12
unnamed: TP39.1, U8.10
unnamed: TP40.1, U8.8
Q: TP36.1, U1.35 (Q), U15.90 (INPUT/OE2/GCLK2)
RomMapped: U6.11, U15.85 (I/O/GCLK3)
Rx: J3.1, R91.2, U4.2 (Rx_Data)
R~W: U1.32 (R/~W), U4.13 (R/~W), U5.21 (R/~W), U15.93 (I/O)
Tx: J3.2, R92.2, U4.6 (Tx_Data)
mA_G_A_DIR: U15.49 (I/O)
mA_G_D_DIR: U15.52 (I/O)
mA_G_ENABLE: U15.47 (I/O)
mA_HALT: R93.2, U6.1, U15.27 (I/O)
mA_READ: U15.29 (I/O)
mA_SHARE_DIRTY: U15.31 (I/O)
mA_SHARE_GRANTED: U15.33 (I/O)
mA_SHARE_REQUEST: U15.36 (I/O)
mA_SHARE_SELECT: U15.54 (I/O)
mA_S_16: U15.24 (I/O)
mA_S_READ: U15.42 (I/O)
mA_S_SELECT: U15.40 (I/O)
mA_S_WRITE: U15.45 (I/O)
mB_G_A_DIR: U15.50 (I/O)
mB_G_D_DIR: U15.53 (I/O)
mB_G_ENABLE: U15.48 (I/O)
mB_HALT: R94.2, U6.13, U15.28 (I/O)
mB_READ: U15.30 (I/O)
mB_SHARE_DIRTY: U15.32 (I/O)
mB_SHARE_GRANTED: U15.35 (I/O)
mB_SHARE_REQUEST: U15.37 (I/O)
mB_SHARE_SELECT: U15.55 (I/O)
mB_S_16: U15.25 (I/O)
mB_S_READ: U15.44 (I/O)
mB_S_SELECT: U15.41 (I/O/PD2)
mB_S_WRITE: U15.46 (I/O)
vCA1: Jx4.1, R90.2, U5.40 (CA1)
vCA2: Jx4.2, R89.2, U5.39 (CA2)
vCB1: Jx1.1, Jx4.3, R88.2, U13.2 (D)
vCB2: Jx4.4, R87.2, U5.19 (CB2)
v~IRQA: Jx4.5, R86.2, U5.38 (~IRQA)
v~IRQB: Jx4.6, R85.2, U5.37 (~IRQB)
~DMA/BREQ: R51.1, TP32.1, U1.33 (~DMA/BREQ), U15.79 (I/O)
~Dev_1: J4.58, J6.58
~Dev_2: J4.59, J6.59
~Dev_3: J4.60, J6.60
~Dev_4: J4.61, J6.61
~Dev_FIRQ: J4.57, J6.57
~Dev_IRQ: J4.56, J6.56
~Dev_NMI: J4.55, J6.55
~Dev_Sel_1: R53.1, U5.23 (~CS2), U7.13, U15.68 (I/O)
~Dev_Sel_2: R54.1, U4.9 (CS2), U7.11, U15.69 (I/O)
~Dev_Sel_3: R55.1, U7.9, U15.70 (I/O)
~Dev_Sel_4: R56.1, U8.5, U15.71 (I/O)
~Dev_Sel_5: R57.1, U8.3, U15.72 (I/O)
~Dev_Sel_6: R58.1, U8.1, U15.75 (I/O)
~Dev_Sel_7: R59.1, TP31.1, U8.13, U15.76 (I/O)
~FIRQ: R50.1, U1.4 (~FIRQ), U15.80 (I/O)
~HALT: R63.2, U1.40 (~HALT), U6.3, U15.92 (I/O)
~IRQ: R49.1, U1.3 (~IRQ), U4.7 (~IRQ), U15.81 (I/O)
~NMI: R48.1, U1.2 (~NMI), U15.83 (I/O)
~RAM: M3.30 (~CS1/~CE1), R98.1, U7.5, U15.67 (I/O)
~ROM: R99.1, U6.9, U14.20 (~CS), U15.65 (I/O)
~Read: M3.32 (~OE), U14.22 (~OE), U15.63 (I/O)
~Reset: C12.1, D2.2 (A), J12.1, R64.2, S1.1, S1.2, U1.37 (~Reset), U5.34 (~Reset), U6.5, U15.89 (INPUT/GCLR)
~Write: M3.5 (~WE), U14.27 (~WE), U15.64 (I/O)

Notes on the sheet:
~Reset, NMI, IRQ, FIRQ,E,R~{W}
OUT
Dev_0 RAM
5 E, R/~W ~Reset, HALT, BA
I2C style pullup
60+2+2
Dev 0
RAM
PULLUPS
ATF - 1
Dev_Sel_0 = RAM Dev_Sel_1 = OnBoard VIA Dev_Sel_2 = OnBoard ACIA Dev_Sel_3 = Bus_1 Dev_Sel_4 = Bus_2 Dev_Sel_5 = Bus_3 Dev_Sel_6 = Bus_4 Dev_Sel_7 = OnBoard future use
2x MHF-002
Dev X
TESTPOINTS
SYSTEM LEDs
For future use maybe
CONFIG
HD6309
A000..A01F
EMS2 4K
A100..FFFF
RANGE
TYP
Native RAM 32K
9000..9FFF
0001
6 GLUE registers (xxx = regnum)
0000
1xxx
0100
Memory mapped devices (? 15 x 16 B?)
0011
6309 memory regions
EMS1 4K
A020..A0FF
Native RAM ~ ROM 23.75K
0000..7FFF
CONTENT
0010
8000..8FFF
