githubgilhad/HW-001/PLD/SOviewer/schema_mhf.kicad_sch

## KiCad design PLD/SOviewer/schema_mhf.kicad_sch (2026-09-03)

Schematic: schema_mhf.kicad_sch

Parts:
C1: 10nF; C_Disc_D4.3mm_W1.9mm_P5.00mm
C2, C5, C6, C7, C8, C10, C15, C16: 100n; C_0805_2012Metric_HandSolder
C3, C4: 22n; C_0805_2012Metric_HandSolder
C9: DTR 100n; C_Disc_D3.0mm_W2.0mm_P2.50mm
C11: 10M; C_0805_2012Metric_HandSolder
C12: 100n RESET; C_Disc_D3.0mm_W2.0mm_P2.50mm
C13, C14: 22p; C_0805_2012Metric_HandSolder
Cx1, Cx2, Cx3, Cx4, Cx5, Cx6, Cx7, Cx8, Cx9, Cx10, Cx11, Cx12, Cx13, Cx16, Cx17, Cx18: Cx; C_Disc_D3.0mm_W2.0mm_P2.50mm
Cx14, Cx15: Cx; CP_Radial_D5.0mm_P2.50mm
D1: 1N4001; D_DO-41_SOD81_P9.4mm_Horizontal
D2, D3: D; D_1210_3225Metric_HandSolder
D4, D5, D6, D7, D8, D9: WS2812B; LED_WS2812B_PLCC4_5.0x5.0mm_P3.2mm_HandSolder
D10: SS14; D_1812_4532Metric_Pad1.30x3.40mm_HandSolder
F1: Polyfuse; Fuse_1206_3216Metric_Pad1.42x1.75mm_HandSolder
H5, H6, H7, H8: MountingHole; MountingHole_3.2mm_M3_Pad
J1: VGA; DSUB-15-HD_Socket_Horizontal_P2.29x2.54mm_EdgePinOffset8.35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
J2: PS/2; J_Mini-DIN-6
J3: RCA; CUI_RCJ-047_Yellow
J4: SysBus; PinSocket_2x32_P2.54mm_Vertical
J5: Micro; USB_Micro-B_XKB_U254-051T-4BH83-F1S
J6: SysBus; PinHeader_2x32_P2.54mm_Vertical_down
J7: SPI; PinHeader_1x06_P2.54mm_Vertical
J8: ISP; PinHeader_2x03_P2.54mm_Vertical
J9: Serial; PinHeader_1x07_P2.54mm_Vertical
J10: I2C; PinHeader_1x04_P2.54mm_Vertical
J11: + 5V -; PinSocket_2x03_P2.54mm_Vertical
J12: Reset; PinHole_1x01_2.54xrectangle
J13, J110: +5V; PinHole_1x01_2.54xrectangle
J14, J108, J111, J112, J116: GND; PinHole_1x01_2.54xrectangle
J15: AREF; PinHole_1x01_2.54xrectangle
J16: XTAL2; PinHole_1x01_2.54xrectangle
J17: SDcard; PinHeader_1x06_P2.54mm_Vertical
J18: XTAL1; PinHole_1x01_2.54xrectangle
J19: AVCC; PinHole_1x01_2.54xrectangle
J20: RCAsel; PinHeader_1x03_P2.54mm_Vertical
J21, J22, J37, J38, J39, J40, J41, J42, J43, J44, J45, J46, J47, J48, J49, J50, J51, J52, J53, J54, J55, J56, J57, J58, J59, J60, J61, J62, J63, J64, J65, J66, J67, J68, J69, J70, J71, J72, J73, J74, J75, J76, J77, J78, J79, J80, J81, J82, J83, J84, J85, J86, J87, J88, J89, J90, J91, J92, J93, J94, J95, J96, J97, J98, J99, J100, J101, J102, J103, J104, J105, J106: x; PinHole_1x01_2.54xrectangle
J23: VIN 12V; BarrelJack_Horizontal
J24: AND_B1; PinHole_1x01_2.54xrectangle
J25: AND_B2; PinHole_1x01_2.54xrectangle
J26: AND_C1; PinHole_1x01_2.54xrectangle
J27: AND_C2; PinHole_1x01_2.54xrectangle
J28: AND_D1; PinHole_1x01_2.54xrectangle
J29: AND_D2; PinHole_1x01_2.54xrectangle
J30: AND_Dx; PinHole_1x01_2.54xrectangle
J31: AND_Cx; PinHole_1x01_2.54xrectangle
J32: AND_Bx; PinHole_1x01_2.54xrectangle
J33: NOTF; PinHole_1x01_2.54xrectangle
J34: NOTE; PinHole_1x01_2.54xrectangle
J35: NOTEx; PinHole_1x01_2.54xrectangle
J36: NOTFx; PinHole_1x01_2.54xrectangle
J107, J109: +3V3; PinHole_1x01_2.54xrectangle
J113: SDCard
J114: VIN; PinHole_1x01_2.54xrectangle
J115: VI; PinHole_1x01_2.54xrectangle
JP1: MISO; SolderJumper-2_P1.3mm_Bridged_Pad1.0x1.5mm
JP2: MOSI; SolderJumper-2_P1.3mm_Bridged_Pad1.0x1.5mm
JP3: SCK; SolderJumper-2_P1.3mm_Bridged_Pad1.0x1.5mm
JP4: SS; SolderJumper-2_P1.3mm_Bridged_Pad1.0x1.5mm
JP5: ANDB1+; SolderJumper-2_P1.3mm_Bridged_Pad1.0x1.5mm
JP6: ANDB2+; SolderJumper-2_P1.3mm_Bridged_Pad1.0x1.5mm
JP7: ANDC1+; SolderJumper-2_P1.3mm_Bridged_Pad1.0x1.5mm
JP8: ANDC2+; SolderJumper-2_P1.3mm_Bridged_Pad1.0x1.5mm
JP9: ANDD1+; SolderJumper-2_P1.3mm_Bridged_Pad1.0x1.5mm
JP10: ANDD2+; SolderJumper-2_P1.3mm_Bridged_Pad1.0x1.5mm
JP11: NOTF; SolderJumper-2_P1.3mm_Bridged_Pad1.0x1.5mm
JP12: HaltLED; SolderJumper-2_P1.3mm_Bridged_Pad1.0x1.5mm
JP13: XHalt; SolderJumper-2_P1.3mm_Bridged_Pad1.0x1.5mm
JP14: xAVCC; SolderJumper-2_P1.3mm_Bridged_Pad1.0x1.5mm
JP15: TX340; SolderJumper-2_P1.3mm_Open_RoundedPad1.0x1.5mm
JP16: RX340; SolderJumper-2_P1.3mm_Open_RoundedPad1.0x1.5mm
JP17: CTS340; SolderJumper-2_P1.3mm_Open_RoundedPad1.0x1.5mm
JP18: DTR340; SolderJumper-2_P1.3mm_Open_RoundedPad1.0x1.5mm
JP19: RTS340; SolderJumper-2_P1.3mm_Open_RoundedPad1.0x1.5mm
JP20: USB_GND; G_Rework_Jumper_Bridged_2.54mm
JP21: RX0; SolderJumper-2_P1.3mm_Open_RoundedPad1.0x1.5mm
JP22: TX0; SolderJumper-2_P1.3mm_Open_RoundedPad1.0x1.5mm
JP23: RTS0; SolderJumper-2_P1.3mm_Open_RoundedPad1.0x1.5mm
JP24: DTR0; SolderJumper-2_P1.3mm_Open_RoundedPad1.0x1.5mm
JP25: CTS0; SolderJumper-2_P1.3mm_Open_RoundedPad1.0x1.5mm
JP26: PS2; PinHeader_1x02_P2.54mm_Vertical
JP27: VGA; PinHeader_1x06_P2.54mm_Vertical
JP28: RCA; PinHeader_1x02_P2.54mm_Vertical
JP29: SBC_D_Dir; SolderJumper-2_P1.3mm_Open_RoundedPad1.0x1.5mm
JP30: USB_PWR; G_Rework_Jumper_Bridged_2.54mm
JP31: USB_D+; G_Rework_Jumper_Bridged_2.54mm
JP32: USB_D-; G_Rework_Jumper_Bridged_2.54mm
JP33: SBC_A_DIR; SolderJumper-2_P1.3mm_Open_RoundedPad1.0x1.5mm
JP34: SBC_G_Enable; SolderJumper-2_P1.3mm_Open_RoundedPad1.0x1.5mm
JP35: SBC_S_SELECT; SolderJumper-2_P1.3mm_Open_RoundedPad1.0x1.5mm
JP36: SBC_Read; SolderJumper-2_P1.3mm_Open_RoundedPad1.0x1.5mm
JP37: SBC_Write; SolderJumper-2_P1.3mm_Open_RoundedPad1.0x1.5mm
JP38: SHSelect; SolderJumper-3_P1.3mm_Open_RoundedPad1.0x1.5mm
JP55: PS2_Data; SolderJumper-2_P1.3mm_Open_RoundedPad1.0x1.5mm
JP56: PS2_CLK; SolderJumper-2_P1.3mm_Open_RoundedPad1.0x1.5mm
JP91: Inside; SolderJumper-2_P1.3mm_Bridged_Pad1.0x1.5mm
JP92: X_S16; SolderJumper-3_P1.3mm_Open_RoundedPad1.0x1.5mm
JP94: A_HALT; SolderJumper-3_P1.3mm_Open_RoundedPad1.0x1.5mm
JP95: A_READ; SolderJumper-3_P1.3mm_Open_RoundedPad1.0x1.5mm
JP98: SHDirty; SolderJumper-3_P1.3mm_Open_RoundedPad1.0x1.5mm
JP99: SHGranted; SolderJumper-3_P1.3mm_Open_RoundedPad1.0x1.5mm
JP100: SHRequest; SolderJumper-3_P1.3mm_Open_RoundedPad1.0x1.5mm
JP102: S_SELECT; SolderJumper-3_P1.3mm_Open_RoundedPad1.0x1.5mm
JP103: S_Read; SolderJumper-3_P1.3mm_Open_RoundedPad1.0x1.5mm
JP104: S_Write; SolderJumper-3_P1.3mm_Open_RoundedPad1.0x1.5mm
JP105: GDdir; SolderJumper-3_P1.3mm_Open_RoundedPad1.0x1.5mm
JP106: GEnable; SolderJumper-3_P1.3mm_Open_RoundedPad1.0x1.5mm
JP107: GADir; SolderJumper-3_P1.3mm_Open_RoundedPad1.0x1.5mm
LED1: RX0; LED_0805_2012Metric
LED2: TX0; LED_0805_2012Metric
LED3: ON; LED_0805_2012Metric
LED4: CTS0; LED_0805_2012Metric
LED5: RTS0; LED_0805_2012Metric
LED6: SCL; LED_0805_2012Metric
LED7: SPI; LED_0805_2012Metric
LED8: HALT; LED_0805_2012Metric
LED9: SYSTEM; LED_0805_2012Metric
LED10: Reset; LED_0805_2012Metric
M1: CP2102; G_CP2102
M3, M5: CY7C109D-10ZXI; G_TSOP-I-32_18.4x8mm_HandSolder
PA1: PA; PinHeader_1x09_P2.54mm_Vertical
PB1: PB; PinHeader_1x09_P2.54mm_Vertical
PC1: PC; PinHeader_1x09_P2.54mm_Vertical
PD1: PD; PinHeader_1x09_P2.54mm_Vertical
PE1: PE; PinHeader_1x09_P2.54mm_Vertical
PF1: PF; PinHeader_1x09_P2.54mm_Vertical
PG1: PG; PinHeader_1x07_P2.54mm_Vertical
PH1: PH; PinHeader_1x09_P2.54mm_Vertical
PJ1: PJ; PinHeader_1x09_P2.54mm_Vertical
PK1: PK; PinHeader_1x09_P2.54mm_Vertical
PL1: PL; PinHeader_1x09_P2.54mm_Vertical
Q1: S8050; TO-92_Inline
Q2: 2907; TSOT-23_HandSoldering
R1: 20k; R_0805_2012Metric_Pad1.20x1.40mm_HandSolder
R2: 440; R_0805_2012Metric_Pad1.20x1.40mm_HandSolder
R3, R28, R36, R37, R38, R39, R40, R41, R42, R43, R46, R48, R49: 1k; R_0805_2012Metric_Pad1.20x1.40mm_HandSolder
R4: 1k3; R_0805_2012Metric_Pad1.20x1.40mm_HandSolder
R5, R16, R17, R18, R19, R20, R21, R22, R23, R26, R44, R45, R47: 10k; R_0805_2012Metric_Pad1.20x1.40mm_HandSolder
R6, R7, R8: 1k2; R_0805_2012Metric_Pad1.20x1.40mm_HandSolder
R9, R10, R11: 680; R_0805_2012Metric_Pad1.20x1.40mm_HandSolder
R12, R13: 3k3; R_0805_2012Metric_Pad1.20x1.40mm_HandSolder
R14, R15: 75; R_0805_2012Metric_Pad1.20x1.40mm_HandSolder
R24, R25, R30, R31: 22; R_0805_2012Metric_Pad1.20x1.40mm_HandSolder
R27, R29: 1M; R_0805_2012Metric_Pad1.20x1.40mm_HandSolder
R32, R33: 4k7; R_0805_2012Metric_Pad1.20x1.40mm_HandSolder
R34, R35: 6k8; R_0805_2012Metric_Pad1.20x1.40mm_HandSolder
R50: 0?; R_0805_2012Metric_Pad1.20x1.40mm_HandSolder
S1: Reset; G_Arduino_switch; PARTREV 1.0
TP1: 7; TestPoint_Pad_1.0x1.0mm
TP2: 0; TestPoint_Pad_1.0x1.0mm
TP3: 1; TestPoint_Pad_1.0x1.0mm
TP4: 2; TestPoint_Pad_1.0x1.0mm
TP5: 3; TestPoint_Pad_1.0x1.0mm
TP6: 4; TestPoint_Pad_1.0x1.0mm
TP7: 5; TestPoint_Pad_1.0x1.0mm
TP8: 6; TestPoint_Pad_1.0x1.0mm
U1: ATMEGA2560; G_TQFP-100_14x14mm_HandSolder
U2: 74HC14; SOIC-14_3.9x8.7mm_P1.27mm
U3: 74HC08; SOIC-14_3.9x8.7mm_P1.27mm
U4: 74AHC573; TSSOP-20_4.4x6.5mm_P0.65mm_HandSolder
U5: 74HC166; SOIC-16_3.9x9.9mm_P1.27mm
U7, U8: 74HC595; SOIC-16_3.9x9.9mm_P1.27mm
U9: 74HC157; SOIC-16_3.9x9.9mm_P1.27mm
U10, U11, U12: 74HC245; G_SOIC-20W_7.5x12.8mm_P1.27mm_HandSolder
U13: CH340G; SOIC-16_3.9x9.9mm_P1.27mm
U14: AMS1117-5.0; SOT-223-3_TabPin2_HandSolder
U15: AMS1117-3.3; SOT-223-3_TabPin2_HandSolder
Y1: 16 MHz; Crystal_SMD_HC49-SD
Y2: 12 MHz; Crystal_SMD_HC49-SD

Connections:
16MHz: PE1.8, U1.9 ((CLKO/ICP3/INT7)PE7), U5.7 (Clk)
+3.3V: C16.1, J107.1, J109.1, U15.2 (VO)
+5V: C6.1, C7.1, C8.1, C10.1, C15.1, Cx1.1, Cx2.1, Cx3.1, Cx4.1, Cx5.1, Cx6.1, Cx7.1, Cx8.1, Cx9.1, Cx10.1, Cx11.1, Cx12.1, Cx13.1, Cx14.1, Cx15.1, Cx16.1, Cx17.1, Cx18.1, D2.1 (K), D4.1 (VDD), D5.1 (VDD), D6.1 (VDD), D7.1 (VDD), D8.1 (VDD), D9.1 (VDD), F1.1, J2.4, J4.1, J4.2, J6.1, J6.2, J7.5, J8.2 (VCC), J9.7, J10.2, J11.1, J11.3, J11.5, J13.1, J17.5, J110.1, J113.5 (VCC), JP5.1 (A), JP6.1 (A), JP7.1 (A), JP8.1 (A), JP9.1 (A), JP10.1 (A), JP11.1 (A), JP14.1 (A), M1.8 (+5V), M3.6 (CS2/CE2), M3.8 (VCC), M5.6 (CS2/CE2), M5.8 (VCC), R3.2, R5.2, R12.2, R13.2, R26.1, R32.1, R33.1, R34.2, R35.2, R36.2, R39.2, R42.1, R47.2, R50.1, U1.10 (VCC), U1.31 (VCC1), U1.61 (VCC2), U1.80 (VCC3), U2.14 (VCC), U3.14 (VCC), U4.20 (VCC), U5.9 (Clr), U5.16 (VCC), U7.10 (~SRCLR), U7.16 (VCC), U8.10 (~SRCLR), U8.16 (VCC), U9.16 (VCC), U11.20 (VCC), U12.20 (VCC), U13.16 (VCC), U14.2 (VO), U15.3 (VI)
A0: J4.11, J6.11, U11.18 (B0)
A1: J4.12, J6.12, U11.17 (B1)
A2: J4.13, J6.13, U11.16 (B2)
A3: J4.14, J6.14, U11.15 (B3)
A4: J4.15, J6.15, U11.14 (B4)
A5: J4.16, J6.16, U11.13 (B5)
A6: J4.17, J6.17, U11.12 (B6)
A7: J4.18, J6.18, U11.11 (B7)
A8: J4.19, J6.19, U12.18 (B0)
A9: J4.20, J6.20, U12.17 (B1)
A10: J4.21, J6.21, U12.16 (B2)
A11: J4.22, J6.22, U12.15 (B3)
A12: J4.23, J6.23, U12.14 (B4)
A13: J4.24, J6.24, U12.13 (B5)
A14: J4.25, J6.25, U12.12 (B6)
A15: J4.26, J6.26, U12.11 (B7)
ALE: PG1.3, U1.70 ((ALE)PG2), U4.11 (Load)
AREF: C5.1, J15.1, U1.98 (AREF)
A_16: J4.27, J6.27, JP92.1 (A)
A_G_A_DIR: J4.47, J6.47, JP107.1 (A)
A_G_D_DIR: J4.49, J6.49, JP105.1 (A)
A_G_ENABLE: J4.45, J6.45, JP106.1 (A)
A_HALT: J4.29, J6.29, JP94.1 (A)
A_READ: J4.31, J6.31, JP95.1 (A)
A_SHARE_DIRTY: J4.33, J6.33, JP98.1 (A)
A_SHARE_GRANTED: J4.35, J6.35, JP99.1 (A)
A_SHARE_REQUEST: J4.37, J6.37, JP100.1 (A)
A_SHARE_SELECT: J4.51, J6.51, JP38.1 (A)
A_S_READ: J4.41, J6.41, JP103.1 (A)
A_S_SELECT: J4.39, J6.39, JP102.1 (A)
A_S_WRITE: J4.43, J6.43, JP104.1 (A)
B_16: J4.28, J6.28, JP92.3 (B)
B_G_A_DIR: J4.48, J6.48, JP107.3 (B)
B_G_D_DIR: J4.50, J6.50, JP105.3 (B)
B_G_ENABLE: J4.46, J6.46, JP106.3 (B)
B_HALT: J4.30, J6.30, JP94.3 (B)
B_READ: J4.32, J6.32, JP95.3 (B)
B_SHARE_DIRTY: J4.34, J6.34, JP98.3 (B)
B_SHARE_GRANTED: J4.36, J6.36, JP99.3 (B)
B_SHARE_REQUEST: J4.38, J6.38, JP100.3 (B)
B_SHARE_SELECT: J4.52, J6.52, JP38.3 (B)
B_S_READ: J4.42, J6.42, JP103.3 (B)
B_S_SELECT: J4.40, J6.40, JP102.3 (B)
B_S_WRITE: J4.44, J6.44, JP104.3 (B)
Bb: PH1.2, U1.13 (PH1(TXD2)), U9.14 (I0d)
Bf: PH1.6, U1.17 (PH5(OC4C)), U9.13 (I1d)
Blue: J1.3, JP27.3, R8.2, R11.2
CTS0: J9.2, JP19.2 (B), JP25.2 (B), PB1.5, R37.2, U1.23 ((OC2A/PCINT4)PB4)
D0: J4.3, J6.3, U10.18 (B0)
D1: J4.4, J6.4, U10.17 (B1)
D2: J4.5, J6.5, U10.16 (B2)
D3: J4.6, J6.6, U10.15 (B3)
D4: J4.7, J6.7, U10.14 (B4)
D5: J4.8, J6.8, U10.13 (B5)
D6: J4.9, J6.9, U10.12 (B6)
D7: J4.10, J6.10, U10.11 (B7)
DTR: C9.2, J9.3, JP18.2 (B), JP24.2 (B), R28.2
Debug_LEDs: D4.4 (DIN), R49.2
GND: C1.2, C2.1, C3.1, C4.1, C5.2, C6.2, C7.2, C8.2, C10.2, C11.2, C12.2, C13.1, C14.1, C15.2, C16.2, Cx1.2, Cx2.2, Cx3.2, Cx4.2, Cx5.2, Cx6.2, Cx7.2, Cx8.2, Cx9.2, Cx10.2, Cx11.2, Cx12.2, Cx13.2, Cx14.2, Cx15.2, Cx16.2, Cx17.2, Cx18.2, D4.3 (VSS), D5.3 (VSS), D6.3 (VSS), D7.3 (VSS), D8.3 (VSS), D9.3 (VSS), J1.0, J1.5, J1.6, J1.7, J1.8, J1.10, J2.3, J2.S (Shield), J3.2 (Ext), J4.63, J4.64, J6.63, J6.64, J7.6, J8.6 (GND), J9.6, J10.1, J11.2, J11.4, J11.6, J14.1, J17.6, J23.2, J23.3, J108.1, J111.1, J112.1, J113.6 (GND), J116.1, JP20.2 (B), JP27.6, JP28.2, LED3.1 (K), LED4.1 (K), LED5.1 (K), LED7.1 (K), LED8.1 (K), LED9.1 (K), M1.9 (GND), M3.24 (GND), M3.30 (~CS1/~CE1), M5.24 (GND), PA1.9, PB1.9, PC1.9, PD1.9, PE1.9, PF1.9, PG1.7, PH1.9, PJ1.9, PK1.9, PL1.9, Q1.1 (E), Q2.3 (C), R28.1, R40.1, S1.3 (K), S1.4 (A), U1.11 (GND), U1.32 (GND1), U1.62 (GND2), U1.81 (GND3), U1.99 (AGND), U2.7 (GND), U3.7 (GND), U4.1 (OE), U4.10 (GND), U5.6 (CE), U5.8 (GND), U7.8 (GND), U8.8 (GND), U9.8 (GND), U10.10 (GND), U11.10 (GND), U12.10 (GND), U13.1 (GND), U14.1 (GND), U15.1 (GND)
G_A_DIR: JP33.2 (B), JP107.2 (C), U11.1 (A->B), U12.1 (A->B)
G_D_DIR: JP29.2 (B), JP105.2 (C), U10.1 (A->B)
G_ENABLE: JP34.2 (B), JP106.2 (C), U10.19 (CE), U11.19 (CE), U12.19 (CE)
Gb: PH1.3, U1.14 (PH2(XCK2)), U9.11 (I0c)
Gf: PH1.7, U1.18 (PH6(OC2B)), U9.10 (I1c)
Green: J1.2, JP27.4, R7.2, R10.2
HSyncVGA_SuppressRCA: PB1.7, R14.2, U1.25 ((OC1B/PCINT6)PB6), U3.2
Ib: PH1.1, U1.12 (PH0(RXD2)), U9.2 (I0a)
If: PH1.5, U1.16 (PH4(OC4B)), U9.3 (I1a)
Inside: JP91.2 (B), PE1.7, U1.8 ((T3/INT6)PE6)
L0: M3.16 (A4), TP2.1, U4.12 (Q7)
L1: M3.15 (A5), TP3.1, U4.13 (Q6)
L2: M3.14 (A6), TP4.1, U4.14 (Q5)
L3: M3.13 (A7), TP5.1, U4.15 (Q4)
L4: M3.17 (A3), TP6.1, U4.16 (Q3)
L5: M3.18 (A2), TP7.1, U4.17 (Q2)
L6: M3.19 (A1), TP8.1, U4.18 (Q1)
L7: M3.20 (A0), TP1.1, U4.19 (Q0)
L-on: LED3.2 (A), R36.1
L-rx: LED1.2 (A), R34.1
L-tx: LED2.2 (A), R35.1
L_13: LED4.2 (A), R37.1
MISO: J7.4, J8.1 (MISO), JP1.2 (B), JP55.1 (A), PB1.4, U1.22 ((MISO/PCINT3)PB3)
MOSI: J7.3, J8.4 (MOSI), JP2.2 (B), JP56.1 (A), PB1.3, U1.21 ((MOSI/PCINT2)PB2)
MasterReset: D10.1 (K), J4.62, J6.62
unnamed: C1.1, D1.2 (A), R1.1, U2.5
unnamed: C2.2, U13.4 (V3)
unnamed: C3.2, R27.2, U13.8 (XO), Y2.1
unnamed: C4.2, R27.1, U13.7 (XI), Y2.2
unnamed: C11.1, D3.1 (K), J115.1, U14.3 (VI)
unnamed: D4.2 (DOUT), D5.4 (DIN)
unnamed: D5.2 (DOUT), D6.4 (DIN)
unnamed: D6.2 (DOUT), D7.4 (DIN)
unnamed: D7.2 (DOUT), D8.4 (DIN)
unnamed: D8.2 (DOUT), D9.4 (DIN)
unnamed: F1.2, JP30.2 (B)
unnamed: J1.13, JP27.2, R14.1
unnamed: J1.14, JP27.1, R15.1
unnamed: J2.5, JP26.1, R13.1, U2.1
unnamed: J5.1 (VBUS), JP30.1 (A)
unnamed: J5.2 (D-), JP32.1 (A)
unnamed: J5.3 (D+), JP31.1 (A)
unnamed: J5.5 (GND), J5.6 (Shield), JP20.1 (A)
unnamed: J19.1, JP14.2 (B), U1.100 (AVCC)
unnamed: J20.2, R5.1, U3.1
unnamed: J20.3, U5.13 (Qh), U9.1 (S)
unnamed: J24.1, JP5.2 (B), U3.4
unnamed: J25.1, JP6.2 (B), U3.5
unnamed: J26.1, JP7.2 (B), U3.9
unnamed: J27.1, JP8.2 (B), U3.10
unnamed: J28.1, JP9.2 (B), U3.12
unnamed: J29.1, JP10.2 (B), U3.13
unnamed: J30.1, U3.11
unnamed: J31.1, U3.8
unnamed: J32.1, U3.6
unnamed: J33.1, JP11.2 (B), U2.13
unnamed: J34.1, JP12.2 (B), U2.11
unnamed: J35.1, R43.2, U2.10
unnamed: J36.1, U2.12
unnamed: J17.1, J113.1 (CS), JP4.1 (A)
unnamed: J17.2, J113.2 (SCK), JP3.1 (A)
unnamed: J17.3, J113.3 (MOSI), JP2.1 (A)
unnamed: J17.4, J113.4 (MISO), JP1.1 (A)
unnamed: JP12.1 (A), JP13.1 (A), PE1.6, U1.7 ((OC3C/INT5)PE5)
unnamed: JP15.1 (A), R30.1
unnamed: JP16.1 (A), R31.1
unnamed: JP17.1 (A), U13.9 (~CTS)
unnamed: JP18.1 (A), U13.13 (~DTR)
unnamed: JP19.1 (A), U13.14 (~RTS)
unnamed: JP21.1 (A), M1.7 (TXD)
unnamed: JP22.1 (A), M1.6 (RXD)
unnamed: JP23.1 (A), M1.4 (CTS)
unnamed: JP24.1 (A), M1.5 (DTR)
unnamed: JP25.1 (A), M1.3 (RTS)
unnamed: JP31.2 (B), R24.2
unnamed: JP32.2 (B), R25.2
unnamed: JP55.2 (B), R45.1
unnamed: JP56.2 (B), R44.1
unnamed: JP91.1 (A), U2.6
unnamed: LED5.2 (A), R38.1
unnamed: LED6.1 (K), Q2.2 (E)
unnamed: LED6.2 (A), R39.1
unnamed: LED7.2 (A), R41.1
unnamed: LED8.2 (A), R43.1
unnamed: LED9.2 (A), R46.1
unnamed: LED10.2 (A), R47.1
unnamed: PD1.5, R48.1, R49.1, U1.47 ((ICP1)PD4)
unnamed: PD1.6, U1.48 ((XCK1)PD5)
unnamed: Q1.2 (B), R4.2
unnamed: R2.1, U3.3
unnamed: R4.1, U2.8
unnamed: R6.1, R7.1, R8.1, U9.4 (Za)
unnamed: R9.1, U9.7 (Zb)
unnamed: R10.1, U9.9 (Zc)
unnamed: R11.1, U9.12 (Zd)
unnamed: R30.2, U13.2 (TXD)
unnamed: R31.2, U13.3 (RXD)
unnamed: R50.2, U10.20 (VCC)
unnamed: U2.2, U2.3, U7.11 (SRCLK), U8.11 (SRCLK)
unnamed: U7.9 (QH'), U8.14 (SER)
PS2 Clock: D1.1 (K), R1.2, R44.2, U2.4, U7.12 (RCLK), U8.12 (RCLK)
PS2 Data: J2.1, JP26.2, R12.1, R45.2, U7.14 (SER)
PS2-OE: PE1.3, U1.4 ((XCK0/AIN0)PE2), U7.13 (~OE), U8.13 (~OE)
PSDat0: R16.1, U8.1 (QB)
PSDat1: R17.1, U8.15 (QA)
PSDat2: R18.1, U7.7 (QH)
PSDat3: R19.1, U7.6 (QG)
PSDat4: R20.1, U7.5 (QF)
PSDat5: R21.1, U7.4 (QE)
PSDat6: R22.1, U7.3 (QD)
PSDat7: R23.1, U7.2 (QC)
RCA_Output: J3.1 (In), JP28.1, Q1.3 (C), R2.2, R3.1
RD: M3.32 (~OE), PG1.2, U1.52 ((RD)PG1)
RD+: R24.1, U13.5 (UD+)
RD-: R25.1, U13.6 (UD-)
RTS0: J9.1, JP17.2 (B), JP23.2 (B), PB1.6, R38.2, U1.24 ((OC1A/PCINT5)PB5)
RX0: J9.4, JP15.2 (B), JP21.2 (B), LED1.1 (K), PE1.1, U1.2 ((RXD0/PCIN8)PE0)
Rb: PH1.4, U1.15 (PH3(OC4A)), U9.5 (I0b)
Red: J1.1, JP27.5, R6.2, R9.2
Reset: C9.1, C12.1, D2.2 (A), D10.2 (A), J8.5 (~RST), J12.1, LED10.1 (K), R26.2, S1.1, S1.2, U1.30 (RESET)
Rf: PH1.8, U1.27 (PH7(T4)), U9.6 (I1b)
SCK: J7.2, J8.3 (SCK), JP3.2 (B), PB1.2, R41.2, U1.20 ((SCK/PCINT1)PB1)
SCL: J10.4, PD1.1, Q2.1 (B), R33.2, U1.43 ((SCL/INT0)PD0)
SDA: J10.3, PD1.2, R32.2, U1.44 ((SDA/INT1)PD1)
SIGNAL_RCA: J20.1, PD1.4, U1.46 ((TXD1/INT3)PD3)
SS: J7.1, JP4.2 (B), PB1.1, U1.19 ((SS/PCINT0)PB0)
S_READ: JP36.2 (B), JP103.2 (C), M5.32 (~OE)
S_SELECT: JP35.2 (B), JP102.2 (C), M5.30 (~CS1/~CE1)
S_WRITE: JP37.2 (B), JP104.2 (C), M5.5 (~WE)
Shared_Address_A0: M5.20 (A0), PJ1.1, U1.63 (PJ0(RXD3/PCINT9)), U11.2 (A0)
Shared_Address_A1: M5.19 (A1), PJ1.2, U1.64 (PJ1(TXD3/PCINT10)), U11.3 (A1)
Shared_Address_A2: M5.18 (A2), PJ1.3, U1.65 (PJ2(XCK3/PCINT11)), U11.4 (A2)
Shared_Address_A3: M5.17 (A3), PJ1.4, U1.66 (PJ3(PCINT12)), U11.5 (A3)
Shared_Address_A4: M5.13 (A7), PJ1.5, U1.67 (PJ4(PCINT13)), U11.6 (A4)
Shared_Address_A5: M5.14 (A6), PJ1.6, U1.68 (PJ5(PCINT14)), U11.7 (A5)
Shared_Address_A6: M5.15 (A5), PJ1.7, U1.69 (PJ6(PCINT15)), U11.8 (A6)
Shared_Address_A7: M5.16 (A4), PJ1.8, U1.79 (PJ7), U11.9 (A7)
Shared_Address_A8: M5.1 (A11), PK1.1, U1.89 (PK0(ADC8/PCINT16)), U12.2 (A0)
Shared_Address_A9: M5.2 (A9), PK1.2, U1.88 (PK1(ADC9/PCINT17)), U12.3 (A1)
Shared_Address_A10: M5.3 (A8), PK1.3, U1.87 (PK2(ADC10/PCINT18)), U12.4 (A2)
Shared_Address_A11: M5.4 (A13), PK1.4, U1.86 (PK3(ADC11/PCINT19)), U12.5 (A3)
Shared_Address_A12: M5.7 (A15), PK1.5, U1.85 (PK4(ADC12/PCINT20)), U12.6 (A4)
Shared_Address_A13: M5.11 (A14), PK1.6, U1.84 (PK5(ADC13/PCINT21)), U12.7 (A5)
Shared_Address_A14: M5.12 (A12), PK1.7, U1.83 (PK6(ADC14/PCINT22)), U12.8 (A6)
Shared_Address_A15: M5.31 (A10), PK1.8, U1.82 (PK7(ADC15/PCINT23)), U12.9 (A7)
Shared_data_D0: M5.29 (DQ7), PL1.1, U1.35 (PL0(ICP4)), U10.2 (A0)
Shared_data_D1: M5.28 (DQ6), PL1.2, U1.36 (PL1(ICP5)), U10.3 (A1)
Shared_data_D2: M5.27 (DQ5), PL1.3, U1.37 (PL2(T5)), U10.4 (A2)
Shared_data_D3: M5.26 (DQ4), PL1.4, U1.38 (PL3(OC5A)), U10.5 (A3)
Shared_data_D4: M5.25 (DQ3), PL1.5, U1.39 (PL4(OC5B)), U10.6 (A4)
Shared_data_D5: M5.23 (DQ2), PL1.6, U1.40 (PL5(OC5C)), U10.7 (A5)
Shared_data_D6: M5.22 (DQ1), PL1.7, U1.41 (PL6), U10.8 (A6)
Shared_data_D7: M5.21 (DQ0), PL1.8, U1.42 (PL7), U10.9 (A7)
TX0: J9.5, JP16.2 (B), JP22.2 (B), LED2.1 (K), PE1.2, U1.3 ((TXD0)PE1)
VGA Latch: PB1.8, R46.2, U1.26 ((OC0A/OC1C/PCINT7)PB7), U5.15 (PE)
VGA data 0: PF1.1, R16.2, U1.97 ((ADC0)PF0), U5.2 (A)
VGA data 1: PF1.2, R17.2, U1.96 ((ADC1)PF1), U5.3 (B)
VGA data 2: PF1.3, R18.2, U1.95 ((ADC2)PF2), U5.4 (C)
VGA data 3: PF1.4, R19.2, U1.94 ((ADC3)PF3), U5.5 (D)
VGA data 4: PF1.5, R20.2, U1.93 ((ADC4/TCK)PF4), U5.10 (E)
VGA data 5: PF1.6, R21.2, U1.92 ((ADC5/TMS)PF5), U5.11 (F)
VGA data 6: PF1.7, R22.2, U1.91 ((ADC6/TDO)PF6), U5.12 (G)
VGA data 7: PF1.8, R23.2, U1.90 ((ADC7/TDI)PF7), U5.14 (H)
VIN: D3.2 (A), J23.1, J114.1
VSyncVGA_RCA: PE1.5, R15.2, U1.6 ((OC3B/INT4)PE4), U2.9
WE: M3.5 (~WE), PG1.1, U1.51 ((WR)PG0)
XAA0: M3.1 (A11), PC1.1, U1.53 ((A8)PC0)
XAA1: M3.2 (A9), PC1.2, U1.54 ((A9)PC1)
XAA2: M3.3 (A8), PC1.3, U1.55 ((A10)PC2)
XAA3: M3.4 (A13), PC1.4, U1.56 ((A11)PC3)
XAA4: M3.7 (A15), PC1.5, U1.57 ((A12)PC4)
XAA5: M3.11 (A14), PC1.6, U1.58 ((A13)PC5)
XAA6: M3.12 (A12), PC1.7, U1.59 ((A14)PC6)
XAA7: M3.31 (A10), PC1.8, U1.60 ((A15)PC7)
XAA16: M3.10 (A16), PG1.4, U1.28 ((TOSC2)PG3)
XAD0: M3.21 (DQ0), PA1.1, U1.78 ((AD0)PA0), U4.9 (D7)
XAD1: M3.22 (DQ1), PA1.2, U1.77 ((AD1)PA1), U4.8 (D6)
XAD2: M3.23 (DQ2), PA1.3, U1.76 ((AD2)PA2), U4.7 (D5)
XAD3: M3.25 (DQ3), PA1.4, U1.75 ((AD3)PA3), U4.6 (D4)
XAD4: M3.26 (DQ4), PA1.5, U1.74 ((AD4)PA4), U4.5 (D3)
XAD5: M3.27 (DQ5), PA1.6, U1.73 ((AD5)PA5), U4.4 (D2)
XAD6: M3.28 (DQ6), PA1.7, U1.72 ((AD6)PA6), U4.3 (D1)
XAD7: M3.29 (DQ7), PA1.8, U1.71 ((AD7)PA7), U4.2 (D0)
XTAL1: C13.2, J18.1, R29.1, U1.33 (XTAL2), Y1.2
XTAL2: C14.2, J16.1, R29.2, U1.34 (XTAL1), Y1.1
X_HALT: JP13.2 (B), JP37.1 (A), JP94.2 (C), R40.2, R42.2
X_READ: JP36.1 (A), JP95.2 (C), PD1.8, U1.50 ((T0)PD7)
X_S16: JP92.2 (C), M5.10 (A16), PE1.4, U1.5 ((OC3A/AIN1)PE3)
X_SHARE_DIRTY: JP34.1 (A), JP98.2 (C), PD1.7, U1.49 ((T1)PD6)
X_SHARE_GRANTED: JP29.1 (A), JP99.2 (C), R48.2
X_SHARE_REQUEST: JP33.1 (A), JP100.2 (C), PG1.5, U1.29 ((TOSC1)PG4)
X_SHARE_SELECT: JP35.1 (A), JP38.2 (C), PG1.6, U1.1 ((OC0B)PG5)
~VGA_Enable: PD1.3, U1.45 ((RXD1/INT2)PD2), U9.15 (E)

Notes on the sheet:
<-- Stop bit (1)
ATMEGA D[0..7]
Facts: NOT = delay 7-14 ns PS/2 = clock at least 30us down 30 us up 595 = SER before SRCLK^ min 25 ns SRCLK^ before RCLK^ min 19 ns SER after SRCLK^ min 0ns Strategy: negate CLK to have RSCLK^ for 595 negate RSCLK again for RCLK^ data latched (min 30us after RSCLK^ >> 19ns)
Data
SDA
<-- LSB
RX for Signal_RCA
Input / Output connector
EMS RAM 8000-9FFF A000-BFFFF (shared between Arduino and HD6309)
<-- Start bit (0)
JUNK (end of prev frame)
ATMEGA A[8..15]
I2C: GND VCC SDA SCL
PB7 is usual Arduino Mega SYSTEM_LED - with VGA it will shine full time
VGA Colors
Clock
External RAM for Arduino
SCL
ATMEGA A[0..7]
POZOR delic 440 x 1k je vypoctena hodnota (R2 R3)
SCK for Signal_RCA
came first
came last
10-20 Ohm, or diode for restricting voltage and lowering ViH under 3.4V
<-- Parity (= parity+data should be odd)
<-- MSB
Shared Memory
