githubgilhad/HW-001/(commit log)

2026-05-15 uvodni nacrt
    [CUI_DEVICES_TS06-667-30-BK-100-G-SMT-TR.step, EEHZA1E470P.step, retro-001.kicad_pcb, retro-001.kicad_sch]
2026-05-24 retro-002, mozna funkcni?
    [CUI_DEVICES_TS06-667-30-BK-100-G-SMT-TR.step, CrossConnect.kicad_sch, CrossConnect_3_.kicad_sch, CrossConnect_4_.kicad_sch, CrossConnect_5_.kicad_sch, EEHZA1E470P.step, retro-001.kicad_pcb, retro-002.kicad_pcb]
2026-05-26 nejaka zmena
    [retro-002.kicad_pcb]
2026-06-05 rozvrzeni registru
    [retro-002.kicad_sch]
2026-06-18 Pridana EEPROM, ucesano, pridana rozpracovana PLD
    [retro-002.kicad_pcb, retro-002.kicad_sch]
2026-06-29 Prvni navrh ATF2
    [retro-002.kicad_sch]
2026-07-24 retro-002 -> retro-003 (ATF1508)
    [CUI_DEVICES_TS06-667-30-BK-100-G-SMT-TR.step, CrossConnect.kicad_sch, CrossConnect_3_.kicad_sch, CrossConnect_4_.kicad_sch, CrossConnect_5_.kicad_sch, EEHZA1E470P.step, retro-003.kicad_pcb, retro-003.kicad_sch]
2026-07-28 ATF3: fits
    [retro-003.kicad_pcb, retro-003.kicad_sch]
2026-08-04 Kicad traces, labels
    [retro-003.kicad_pcb, retro-003.kicad_sch]
2026-08-20 PCB finished, ready to be send to JLCpcb
    [retro-003.kicad_pcb, retro-003.kicad_sch]
2026-08-20 PCB send to JLCpcb (with prev git number)
    [retro-003-B_Cu.gbl, retro-003-B_Mask.gbs, retro-003-B_Paste.gbp, retro-003-B_Silkscreen.gbo, retro-003-Edge_Cuts.gm1, retro-003-F_Cu.gtl, retro-003-F_Mask.gts, retro-003-F_Paste.gtp]
2026-08-22 fixed polarity of IRQ, FIRQ, ... pins
    [retro-003.kicad_pcb]
2026-08-22 fixed PCB send to JLCpcb (with prev git number) - flood copper on outside
    [retro-003-B_Cu.gbl, retro-003-B_Mask.gbs, retro-003-B_Paste.gbp, retro-003-B_Silkscreen.gbo, retro-003-Edge_Cuts.gm1, retro-003-F_Cu.gtl, retro-003-F_Mask.gts, retro-003-F_Paste.gtp]
2026-09-03 +PLD/SOviewer GUI; +retro-003-simul; +Comp24_ATF_GLUE.PSI (před velkým přepsáním a SHARE_DIRTY => SHARE_COOP)
    [CrossConnect.kicad_sch, CrossConnect_3_.kicad_sch, CrossConnect_4_.kicad_sch, CrossConnect_5_.kicad_sch, retro-003-simul.kicad_pcb, retro-003-simul.kicad_sch, retro-003.kicad_sch, schema_atf.kicad_sch]
2026-09-04 Snad odladeno az do klasickeho bootu
    [retro-003-simul.kicad_sch]
